abdellrahmanv/PLUTO-2026/feature_memory/STATE-3.33_welcome_talk_v1.md

# Feature Memory: WELCOME_TALK v1 Offline Answer Engine

Status: implemented, local smoke validated

Last updated: 2026-06-09

Last validated: 2026-06-09 local smoke test; Raspberry Pi camera mic/Piper probe recorded in `AUD-001_audio_io_v1.md`

Owner: Pluto systems engineering

## Requirement Trace

Implemented requirements:

```text
TIME-009
AUD-013
AUD-014
AUD-015
AUD-016
AUD-018
AUD-019
AUD-022
STATE-3.33
STATE-3.33.1
STATE-3.33.2
STATE-3.33.3
STATE-3.33.4
STATE-3.33.5
STATE-3.33.6
STATE-3.33.9
STATE-3.33.10
STATE-3.33.11
STATE-3.33.12
STATE-3.33.13
STATE-3.35
STATE-3.37
```

Verification tests:

```text
tools/welcome_talk_smoke.py
tools/web_shell_smoke.py
tools/audio_io_smoke.py
```

## Design Intent

Make WELCOME_TALK fast, offline, and good enough for a welcoming robot. Pluto
answers short visitor questions using a deterministic local response bank
instead of waiting for an LLM.

## Design Decision

v1 uses a local keyword/fuzzy intent engine in:

```text
pluto_runtime/welcome_talk.py
```

This was chosen because Pluto needs small latency more than perfect language
understanding. Ollama/Qwen remains a v1.5 fallback candidate only after a
benchmark gate.

The 2026-06-09 talk expansion keeps the same non-LLM architecture but adds an
alias-assisted word matcher and deterministic script bank. This lets Pluto
answer more naturally around demo, safety, sensors, deployment, and presentation
topics without introducing unbounded generation.

## Interfaces

Inputs:

- Website text fallback through `POST /api/welcome/talk`.
- Camera microphone STT text through `pluto_runtime/audio_io.py`.

Outputs:

- Short response text.
- Response source: `keyword`, `fuzzy`, `fallback`, or `blocked`.
- Intent name, score, input word count, output word count, latency.
- Web status under `status.talk`.

External dependencies:

- None for v1 answer selection.

## Configuration

| Name | Default | Allowed Range | Reason |
| --- | --- | --- | --- |
| `version` | `v1` | `v1` | Locks offline deterministic behavior |
| `primary_engine` | `keyword` | `keyword` | Keeps response path traceable |
| `enable_ollama_fallback` | `false` | bool | v1.5 only after benchmark |
| `max_input_words` | 9 | 1-12 | Keeps questions tiny |
| `max_output_words` | 9 | 1-12 | Keeps answers quick |
| `fuzzy_threshold` | 0.68 | 0.0-1.0 | Allows small STT mistakes |

## Runtime Behavior

The web API only answers while the mode manager is in `WELCOME`. Before
answering, the Pi sends a stop guard to STM32 so wheel motion stays zero during
talk. The persistent STM32 link retries `CMD:STOP` up to three times because a
single `ACK:STOP` can be delayed while telemetry is arriving. If the ACK is
still missing but the STM32 link is recent, wheel speed telemetry is zero, and
manual intent is zero, WELCOME_TALK may proceed in a logged degraded guard mode
because this state is speech-only.

Normal flow:

```text
POST /api/welcome/talk
  -> require current_state == WELCOME
  -> send CMD:STOP
  -> set substate WELCOME_TALK
  -> normalize text
  -> enforce <= 9 input words
  -> keyword/script/fuzzy match
  -> return <= 9 output words
  -> log response source and latency
```

Current bank coverage:

```text
identity: name, project, builders, version
location/demo: MSA University in Egypt, graduation demo, weather
MSA knowledge: official facts, faculties, contacts, partners, campus numbers
system: modes, website, STM32, Raspberry Pi, hoverboard, Uno
safety: stop, obstacle, distance, human safety, camera avoidance
interaction: greeting, goodbye, thanks, welcome wave, approach
personality: feeling, alive, happy, jokes, favorites, dreams
debug: tests, requirements, logs, confidence, noise
audio: microphone, headset/webcam mic, speaker, local/offline speech
deployment: Pi service, Wi-Fi portal, production readiness, branching
script bank: demo open/close, system, safety, sensors, modes, judges
matching method: exact keywords, alias groups, scripted lines, fuzzy fallback
```

Current bank size validated by smoke test:

```text
intent_count >= 180
script_count >= 30
response_bank_size >= 210
alias_group_count >= 20
```

Exact demo facts locked by smoke tests:

```text
"where are you" -> "MSA University in Egypt."
"who made pluto" -> "Abdelrahman and Hamza built me."
"weather" -> "It is slightly hot today."
"what means msa" -> "October University for Modern Sciences and Arts."
```

## How To Run

Local smoke:

```bash
python tools/welcome_talk_smoke.py
python tools/audio_io_smoke.py
```

With an already running Pi web server:

```bash
python tools/welcome_talk_smoke.py --host 192.168.137.2 --port 8080 --external-server --hardware-flow
```

Manual API test:

```bash
curl -X POST http://127.0.0.1:8080/api/welcome/talk \
  -H "Content-Type: application/json" \
  -d '{"text":"what is your name"}'
```

## How To Debug

Checklist:

1. Check `/api/status` and confirm `talk.version` is `v1`.
2. Confirm current state is `WELCOME`; otherwise talk is rejected.
3. Confirm `stop_guard.ok` is true before trusting TALK output.
4. Check `talk.last_result.response_source`.
5. If the response is wrong, add a trigger to `INTENT_RULES` or `SCRIPT_RULES`.
6. If input is blocked, check `input_words`.

Useful commands:

```bash
python tools/welcome_talk_smoke.py
curl http://127.0.0.1:8080/api/status
```

Bank audit:

```bash
python - <<'PY'
from pluto_runtime.welcome_talk import INTENT_RULES, SCRIPT_RULES
for rule in INTENT_RULES:
    print(rule.intent, "=>", rule.response)
for rule in SCRIPT_RULES:
    print(rule.script, rule.step, "=>", rule.response)
PY
```

## Expected Evidence

Known keyword:

```text
response_source=keyword
intent=name
response="I am Pluto."
response_words<=9
```

Long question:

```text
accepted=false
reason=input_too_long
response="Short question please."
```

Scripted prompt:

```text
input="demo script"
response_source=script
intent=script_demo_opening
response="Welcome. I am Pluto, your graduation robot."
```

## Verification Tests

| Test ID | Method | Expected Result | Last Result |
| --- | --- | --- | --- |
| VER-TALK-001 | Known keyword question | `keyword`, answer <= 9 words | local pass |
| VER-TALK-002 | 10-word question | blocked with short-question response | local pass |
| VER-TALK-003 | Response bank audit | all responses <= 9 words | local pass |
| VER-TALK-005 | No internet/API keys | engine imports no cloud dependency | local pass |
| VER-TALK-006 | Demo fact prompts | location/builders/weather exact answers | local pass |
| VER-TALK-007 | MSA knowledge prompts | official MSA facts answer locally | local pass |
| VER-TALK-008 | Script prompt | `script`, answer <= 9 words | 2026-06-09 local pass |
| VER-TALK-009 | Matching-method prompt | local alias/script/fuzzy method explained | 2026-06-09 local pass |

## Failure Modes

| Failure | Likely Cause | Diagnostic | Recovery |
| --- | --- | --- | --- |
| Talk rejected | Not in WELCOME | Check `current_state` | Enter WELCOME first |
| Stop ACK buried | Alert/telemetry flood from STM32 | Check `stop_guard.degraded` and speed telemetry | Speech-only TALK may continue |
| Stop guard fails | STM32 disconnected or nonzero speed | Check `stop_guard.attempts` and STM32 runtime | Fix STM32 link before TALK |
| Wrong answer | Missing trigger or STT error | Check `normalized_text` and `score` | Add trigger or response |
| Over-broad alias | Alias group matches too much | Check `response_source`, `score`, and trigger | Add specific trigger or tighten alias |
| Long input blocked | More than 9 words | Check `input_words` | Ask shorter question |

## Safety Notes

WELCOME_TALK v1 sends no wheel or arm movement. It requires WELCOME state and
uses a `CMD:STOP` guard before answering. Degraded guard mode is allowed only
when STM32 is alive and speed telemetry is zero.

## Open Questions

- Which answers should be promoted into pre-rendered Piper audio?
- Should common TTS lines be cached as audio files in the next phase?

## Change History

| Date | Change | Reason |
| --- | --- | --- |
| 2026-05-27 | Initial implementation memory | WELCOME_TALK v1 answer engine added |
| 2026-05-27 | Expanded demo bank | Add MSA University, builders, weather, safety, and interaction facts |
| 2026-05-27 | Added MSA knowledge bank | Add short official-source facts about MSA University |
| 2026-06-09 | Added scripted matching bank | Make talk feel richer without enabling an LLM |
