abdellrahmanv/PLUTO-2026/docs/figures/pluto_runtime_flowchart_book_ready.pdf

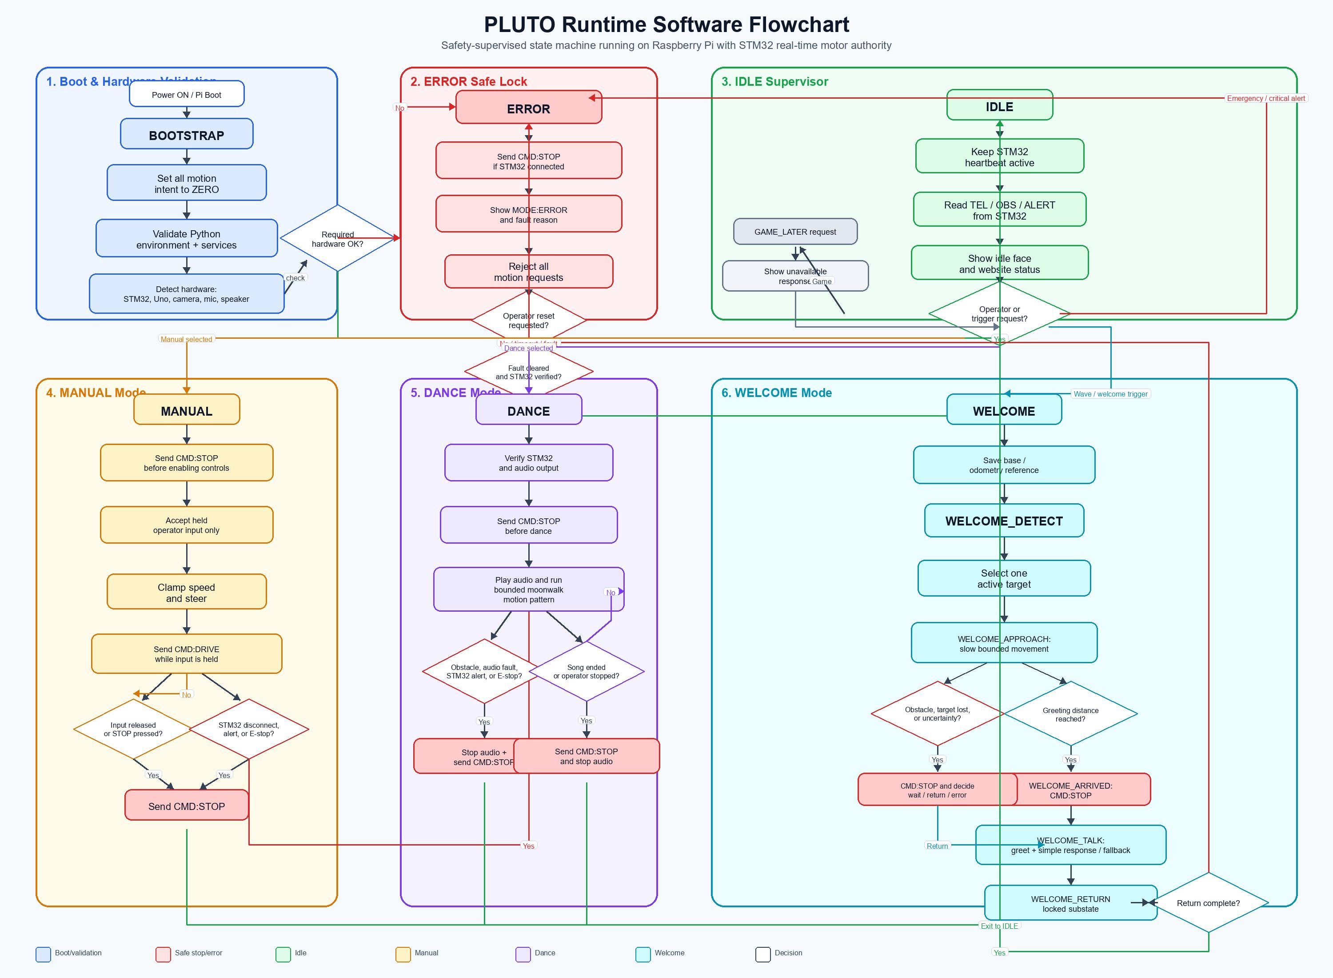
[picture p1: page 1]
