abdellrahmanv/PLUTO-2026/docs/figures/pluto_runtime_flowchart_professional.pdf

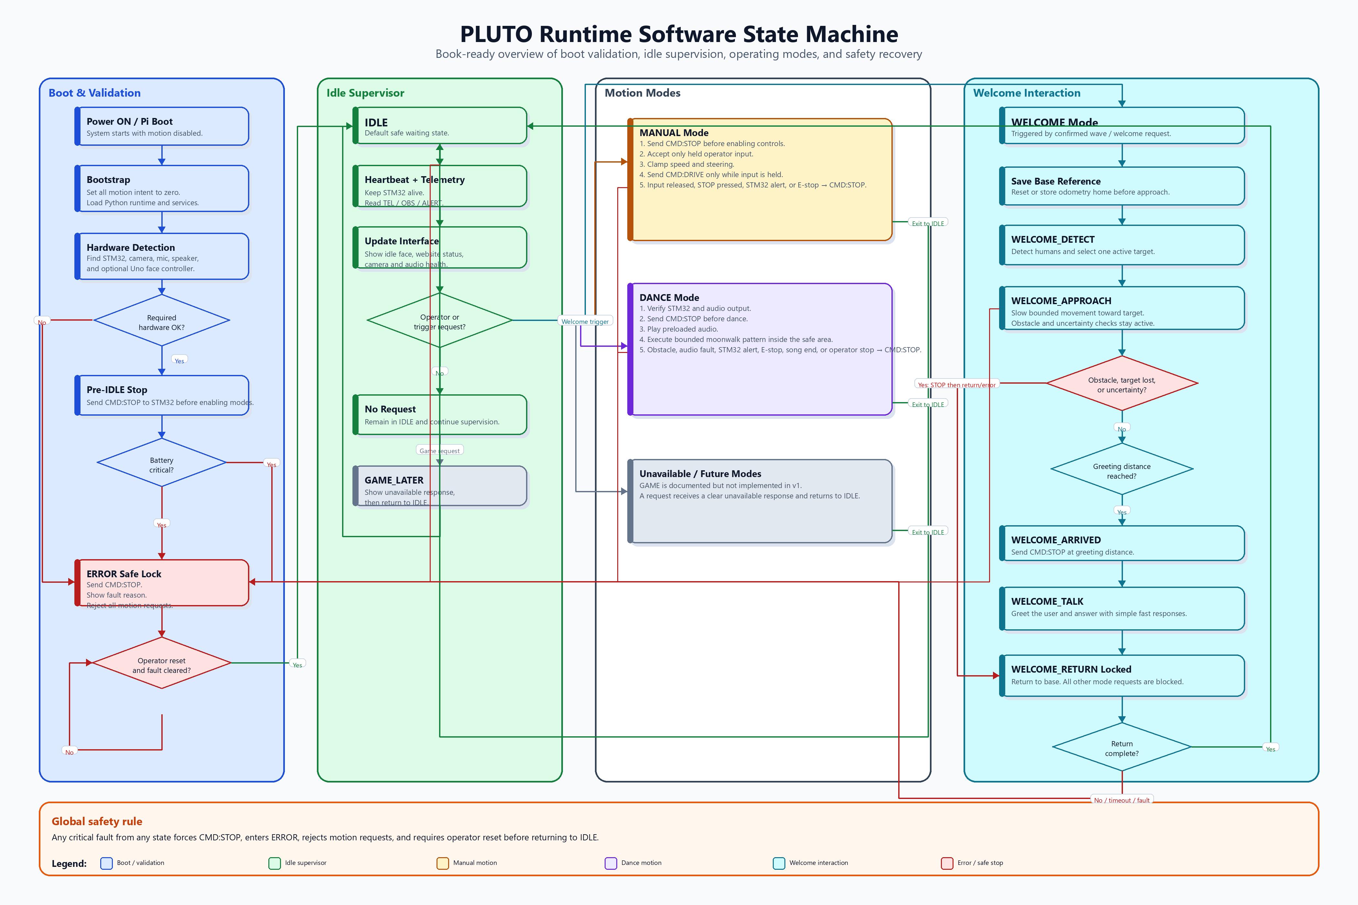
[picture p2: page 1]
