abdellrahmanv/PLUTO-2026/docs/figures/pluto_runtime_flowchart_professional_v3.pdf

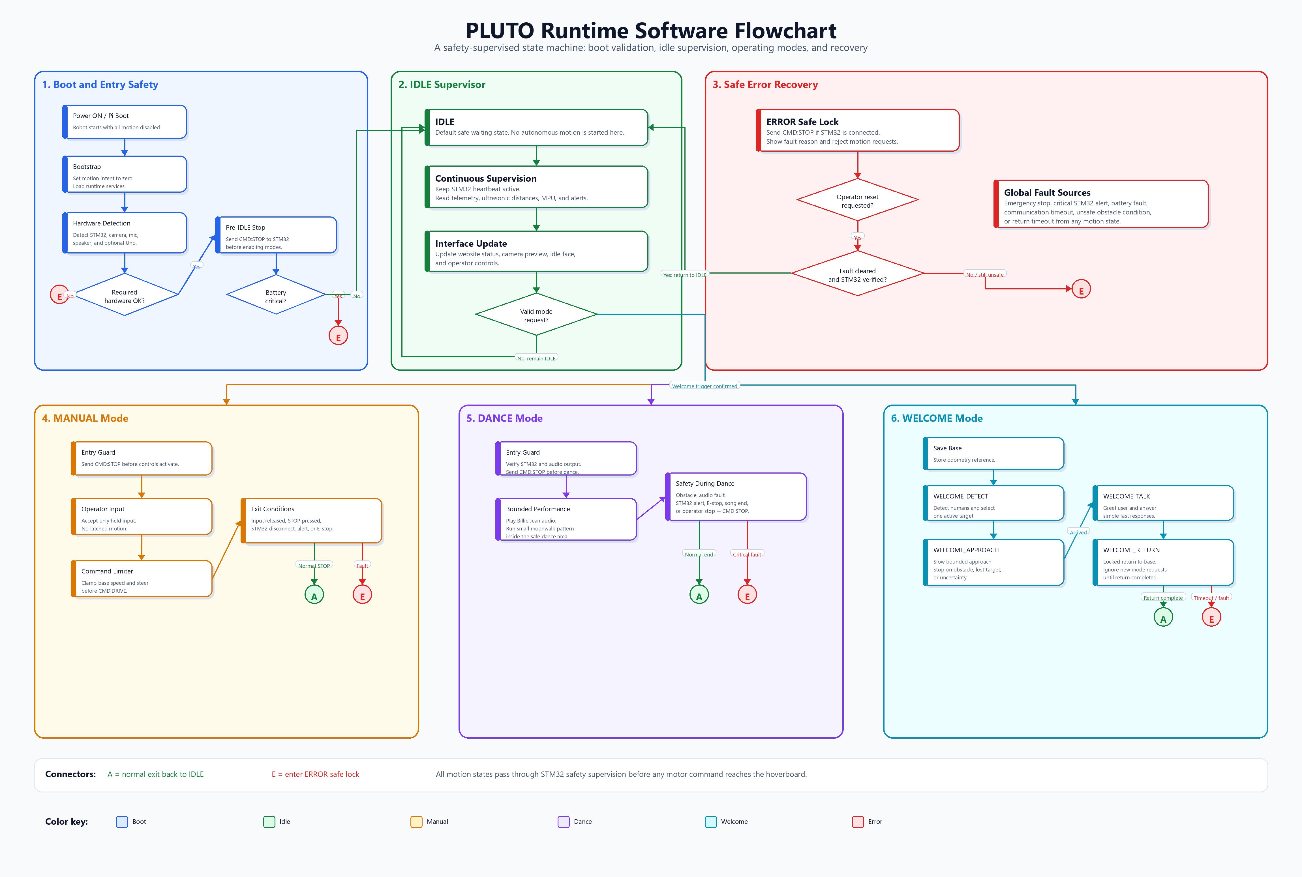
[picture p3: page 1]
