abdellrahmanv/PLUTO-2026/docs/figures/pluto_runtime_flowchart_professional_v3.png

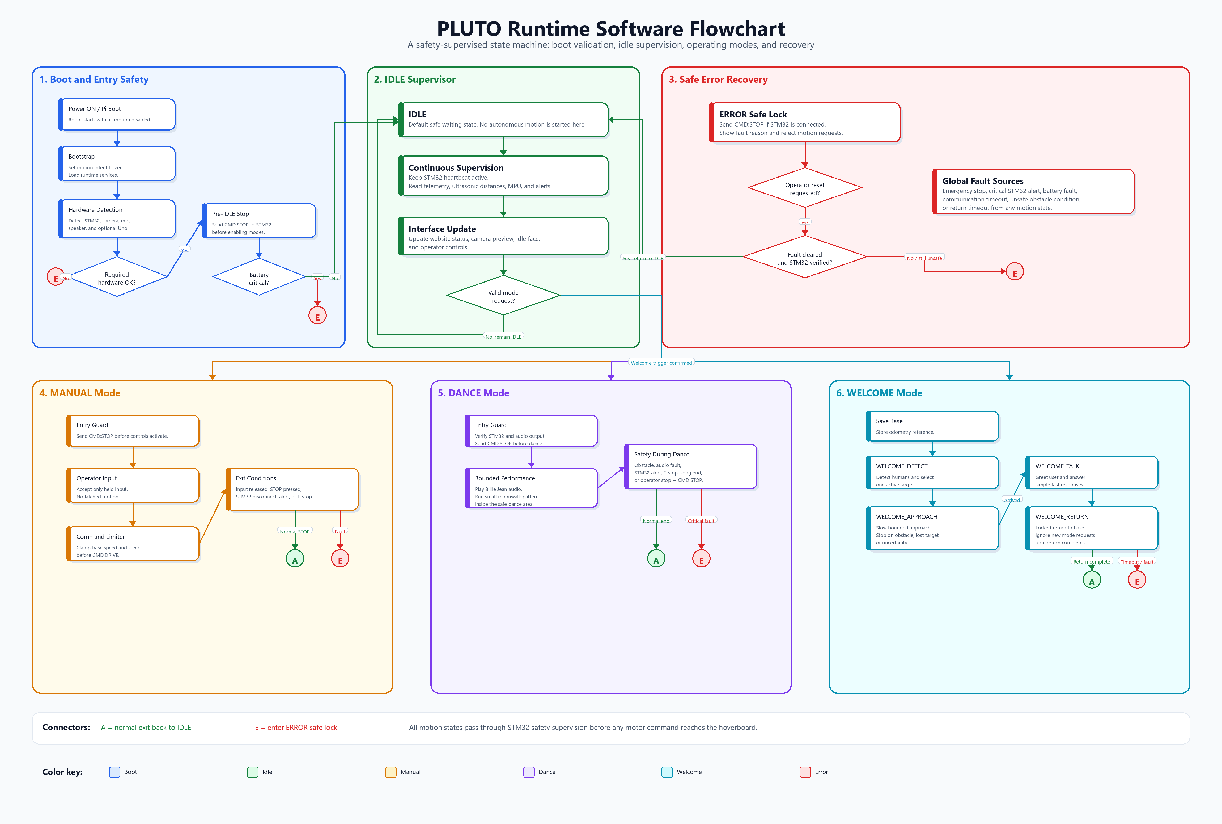
docs/figures/pluto_runtime_flowchart_professional_v3.png
