abdellrahmanv/PLUTO-2026/pluto_runtime/static/robot_meshes/back_leftwheel.STL

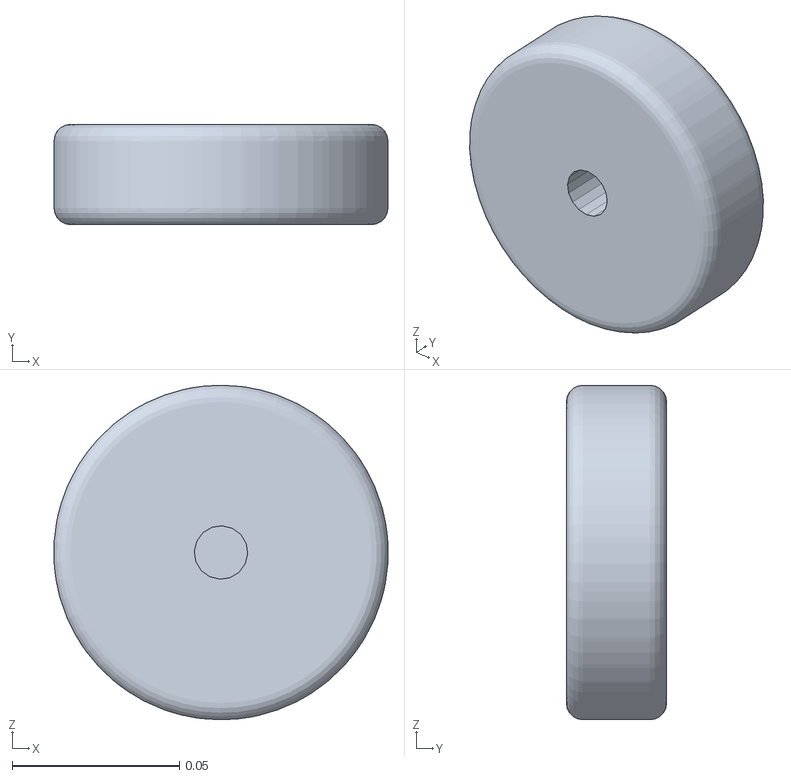
[picture p5: CAD file, 2026-06-17]
pluto_runtime/static/robot_meshes/back_leftwheel.STL
0.0999 x 0.03 x 0.1
