abdellrahmanv/PLUTO-2026/pluto_runtime/static/robot_meshes/leftarm.STL

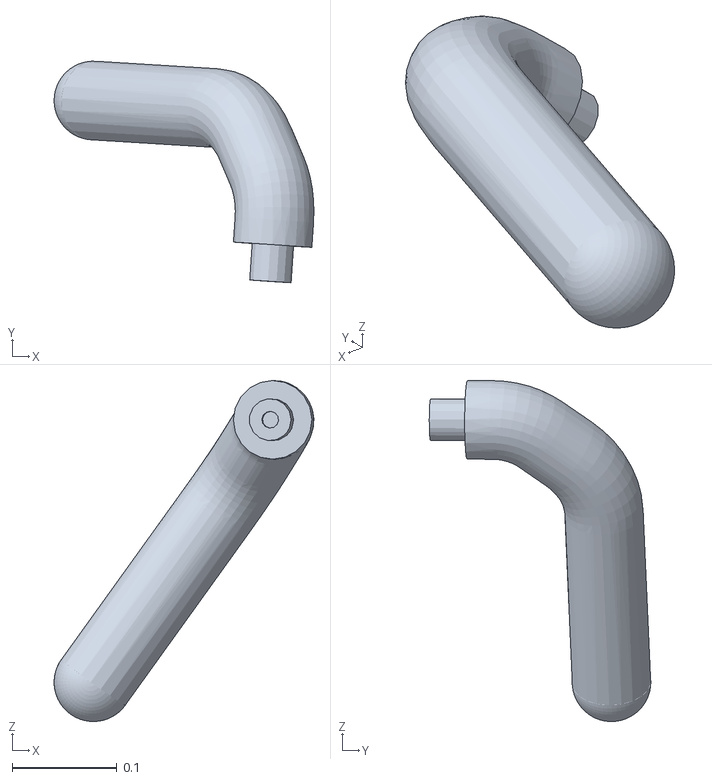
[picture p6: CAD file, 2026-06-17]
pluto_runtime/static/robot_meshes/leftarm.STL
0.248 x 0.211 x 0.325
