abdellrahmanv/PLUTO-2026/pluto_runtime/static/robot_meshes/base_link.STL

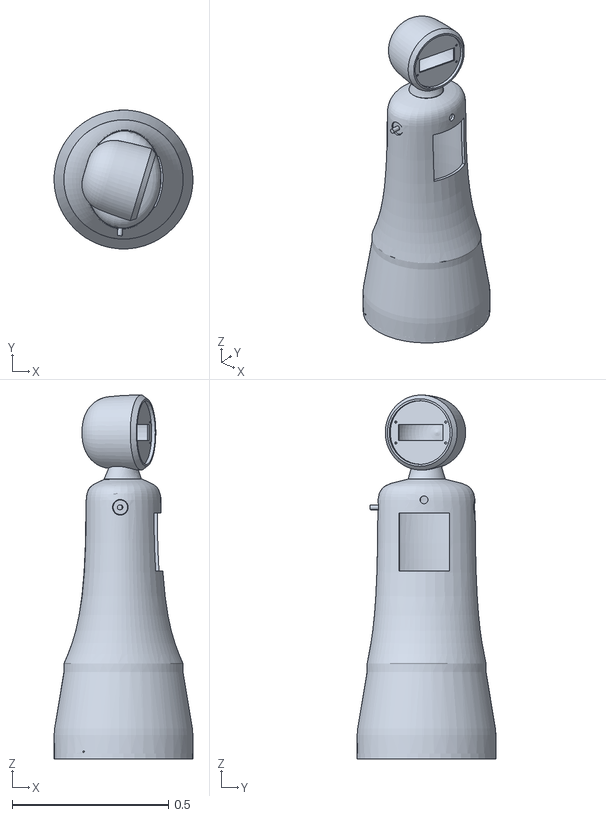
[picture p7: CAD file, 2026-06-17]
pluto_runtime/static/robot_meshes/base_link.STL
0.444 x 0.444 x 1.16
