abdellrahmanv/PLUTO-2026/pluto_runtime/static/robot_meshes/rightarm.STL

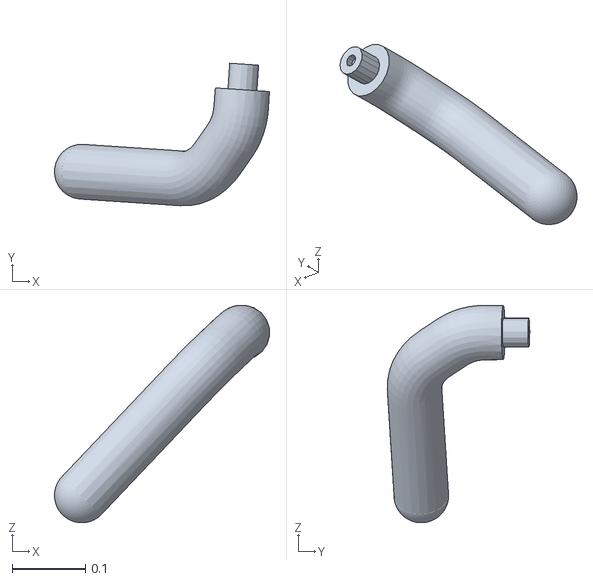
[picture p8: CAD file, 2026-06-17]
pluto_runtime/static/robot_meshes/rightarm.STL
0.294 x 0.195 x 0.298
