abdellrahmanv/PLUTO-2026/(list of files, cad)

Other CAD files:
pluto_runtime/static/robot_meshes/back_rigtwheel.STL
pluto_runtime/static/robot_meshes/front_rightwheel.STL
pluto_runtime/static/robot_meshes/front_leftwheel.STL
