abdellrahmanv/PLUTO-2026/pluto_runtime/web_shell.py

#!/usr/bin/env python3
"""
Phase 6 PLUTO operator website shell.

This is intentionally not the final app. It provides the first safe operator
console surface: project identity, state/status display, hardware status,
events, blocked state requests, and emergency stop wiring.
"""

from __future__ import annotations

import argparse
import glob
import json
import math
import platform
import socket
import subprocess
import sys
import threading
import time
import wave
from collections import deque
from dataclasses import asdict, dataclass, field
from datetime import datetime
from http import HTTPStatus
from http.server import BaseHTTPRequestHandler, ThreadingHTTPServer
from pathlib import Path
from typing import Any, Iterable
from urllib.parse import urlparse

from .audio_io import AudioRuntime
from .camera import CameraService, CameraStatus, status_to_dict
from .dance import DanceDryRunPlanner, DanceStatus
from .dance_live import (
    DISTANCE_TOLERANCE_M,
    MAX_SPEED as DANCE_MAX_SPEED,
    MIN_SPEED as DANCE_MIN_SPEED,
    MIN_STEER as DANCE_MIN_STEER,
    SAFE_OBSTACLE_DISTANCE_CM as DANCE_SAFE_OBSTACLE_DISTANCE_CM,
    TARGET_DISTANCE_M as DANCE_TARGET_DISTANCE_M,
    TARGET_TURN_DEG as DANCE_TARGET_TURN_DEG,
    TURN_TOLERANCE_DEG,
    angle_delta_deg,
)
from .mode_manager import SafetyContext, ModeManager, VALID_STATES
from .stm32_link import Stm32SerialLink, status_to_dict as stm32_status_to_dict
from .validation_center import ValidationCenter
from .wave_detection import SimpleWaveDetector
from .welcome_approach import ApproachStatus, WelcomeApproachPlanner
from .welcome_interaction import WelcomeInteractionFSM
from .welcome_talk import TalkResult, WelcomeTalkEngine


PROJECT_NAME = "PLUTO"
STM32_ID = "ID:STM32_MOTOR"
UNO_ID = "ID:UNO_LCD"
STATIC_DIR = Path(__file__).resolve().with_name("static")
DANCE_FALLBACK_AUDIO = Path("/tmp/pluto_dance_beat.wav")
DANCE_OPEN_LOOP_MOVE_S = 2.0
DANCE_OPEN_LOOP_TURN_S = 1.6
STATIC_TYPES = {
    ".js": "text/javascript; charset=utf-8",
    ".mjs": "text/javascript; charset=utf-8",
    ".css": "text/css; charset=utf-8",
    ".png": "image/png",
    ".jpg": "image/jpeg",
    ".jpeg": "image/jpeg",
    ".svg": "image/svg+xml",
    ".stl": "model/stl",
}


@dataclass
class HardwareDevice:
    name: str
    required: bool
    connected: bool = False
    port: str | None = None
    status: str = "unknown"
    detail: str = "not checked"
    latency_ms: float | None = None
    last_seen: float | None = None


@dataclass
class Event:
    timestamp: float
    level: str
    message: str


@dataclass
class PlutoStatus:
    project: str = PROJECT_NAME
    current_state: str = "BOOTSTRAP"
    current_substate: str = "WEB_SHELL"
    fault_reason: str | None = None
    git_commit: str = "unknown"
    started_at: float = field(default_factory=time.time)
    hardware: dict[str, HardwareDevice] = field(default_factory=dict)
    allowed_next_states: list[dict[str, Any]] = field(default_factory=list)
    bootstrap_report: dict[str, Any] = field(default_factory=dict)
    camera: dict[str, Any] = field(default_factory=dict)
    mode_manager: dict[str, Any] = field(default_factory=dict)
    stm32_runtime: dict[str, Any] = field(default_factory=dict)
    error: dict[str, Any] = field(default_factory=dict)
    manual: dict[str, Any] = field(default_factory=dict)
    wave: dict[str, Any] = field(default_factory=dict)
    welcome_interaction: dict[str, Any] = field(default_factory=dict)
    welcome_approach: dict[str, Any] = field(default_factory=dict)
    dance: dict[str, Any] = field(default_factory=dict)
    talk: dict[str, Any] = field(default_factory=dict)
    audio: dict[str, Any] = field(default_factory=dict)
    events: list[Event] = field(default_factory=list)


@dataclass
class ManualRuntime:
    enabled: bool = False
    speed_intent: int = 0
    steer_intent: int = 0
    max_speed: int = 400
    max_steer: int = 400
    base_speed_setting: int = 100
    base_steer_setting: int = 100
    arm_step_setting: int = 5000
    arm_speed_setting: int = 2000
    max_arm_steps: int = 10000
    max_arm_speed: int = 3000
    command_period_ms: int = 40
    last_command_at: float | None = None
    last_intent_at: float | None = None
    last_repeat_at: float | None = None
    last_release_at: float | None = None
    last_neutral_at: float | None = None
    last_neutral_result: dict[str, Any] = field(default_factory=dict)
    last_repeat_result: dict[str, Any] = field(default_factory=dict)
    last_arm_command: dict[str, Any] = field(default_factory=dict)
    last_result: dict[str, Any] = field(default_factory=dict)
    command_count: int = 0
    repeat_count: int = 0
    blocked_reason: str | None = None


@dataclass
class DanceLiveRuntime:
    enabled: bool = False
    active: bool = False
    use_ultrasonic: bool = True
    current_step: str = "idle"
    step_index: int = 0
    total_steps: int = 6
    started_at: float | None = None
    completed_at: float | None = None
    last_update_at: float | None = None
    last_result: dict[str, Any] = field(default_factory=dict)
    last_error: str | None = None
    last_command: dict[str, Any] = field(default_factory=dict)
    measured_distance_m: float = 0.0
    measured_turn_deg: float = 0.0
    target_distance_m: float = DANCE_TARGET_DISTANCE_M
    target_turn_deg: float = DANCE_TARGET_TURN_DEG
    forward_speed: int = DANCE_MAX_SPEED
    backward_speed: int = DANCE_MIN_SPEED
    rotation_steer: int = DANCE_MIN_STEER
    obstacle_stop_cm: float = DANCE_SAFE_OBSTACLE_DISTANCE_CM
    audio_file: str | None = None


@dataclass
class WaveTriggerRuntime:
    enabled: bool = True
    detector_status: str = "tracked_pose_wave"
    sample_hz: float = 8.0
    last_sample_at: float | None = None
    thresholds: dict[str, Any] = field(default_factory=dict)
    armed_until: float = 0.0
    armed_source: str | None = None
    trigger_count: int = 0
    rejected_count: int = 0
    last_event: dict[str, Any] | None = None
    last_result: dict[str, Any] | None = None
    last_reason: str = "no wave trigger yet"
    detector: dict[str, Any] = field(default_factory=dict)
    pending_confirmed_until: float = 0.0
    last_confirmed_detector: dict[str, Any] = field(default_factory=dict)


class PlutoWebContext:
    def __init__(
        self,
        serial_baud: int = 115200,
        camera_device: str | None = None,
        camera_resolution: tuple[int, int] = (320, 320),
        camera_fps: int = 30,
        camera_stream_fps: int = 8,
        camera_frame_skip: int = 1,
        camera_detection_hold: float = 2.0,
        camera_confidence: float = 0.30,
        camera_disabled: bool = False,
        yolo_model: str | None = None,
        wave_pose_model: str | None = None,
        wave_pose_disabled: bool = False,
        wave_pose_frame_skip: int = 1,
        wave_pose_max_tracks: int = 2,
        microphone_device: str | None = None,
        speaker_device: str | None = None,
        fast_start: bool = False,
    ) -> None:
        self.serial_baud = serial_baud
        self.lock = threading.RLock()
        self.events: deque[Event] = deque(maxlen=80)
        self.started_at = time.time()
        self.mode_manager = ModeManager()
        self.stm32_link: Stm32SerialLink | None = None
        self.manual = ManualRuntime()
        self.wave = WaveTriggerRuntime()
        self.wave_detector = SimpleWaveDetector()
        self.wave.thresholds = self.wave_detector.thresholds()
        self.wave_thread_running = True
        self.wave_thread: threading.Thread | None = None
        self.manual_thread_running = True
        self.manual_thread: threading.Thread | None = None
        self.startup_thread: threading.Thread | None = None
        self.uno_thread_running = False
        self.uno_thread: threading.Thread | None = None
        self.uno_port: str | None = None
        self.approach_planner = WelcomeApproachPlanner()
        self.approach_status = ApproachStatus()
        self.approach_last_stop_at = 0.0
        self.dance_planner = DanceDryRunPlanner()
        self.dance_status = DanceStatus()
        self.dance_started_at: float | None = None
        self.dance_last_stop_at = 0.0
        self.dance_audio_started = False
        self.dance_live = DanceLiveRuntime()
        self.dance_live_thread: threading.Thread | None = None
        self.dance_live_stop = threading.Event()
        self.talk_engine = WelcomeTalkEngine()
        self.talk_last_result: TalkResult | None = None
        self.talk_history: deque[TalkResult] = deque(maxlen=20)
        self.talk_last_notice = "Enter WELCOME, then ask a short question."
        self.audio_runtime = AudioRuntime(preferred_microphone=microphone_device, preferred_speaker=speaker_device)
        self.auto_welcome_no_human_since: float | None = None
        self.validation_center = ValidationCenter()
        self.last_alert_escalated: str | None = None
        self.git_commit = read_git_commit()
        self.camera_disabled = camera_disabled
        self.camera_resolution = camera_resolution
        self.camera_frame_skip = camera_frame_skip
        self.hardware = {
            "stm32": HardwareDevice("STM32 motor safety controller", True),
            "uno": HardwareDevice("Uno LCD face controller", False),
            "camera": HardwareDevice("Camera", False, status="starting", detail="Phase 4"),
            "speaker": HardwareDevice("Speaker", False, status="starting", detail="Phase 9 audio"),
            "microphone": HardwareDevice("Microphone", False, status="starting", detail="Phase 9 audio"),
        }
        self.log("info", "PLUTO web shell starting")
        self.camera_service = CameraService(
            device=camera_device,
            resolution=camera_resolution,
            framerate=camera_fps,
            stream_fps=camera_stream_fps,
            frame_skip=camera_frame_skip,
            detection_hold_s=camera_detection_hold,
            confidence_threshold=camera_confidence,
            model_path=yolo_model,
            pose_model_path=wave_pose_model,
            pose_enabled=not wave_pose_disabled,
            pose_frame_skip=wave_pose_frame_skip,
            pose_max_tracks=wave_pose_max_tracks,
        )
        self.camera_perception_mode = "NORMAL"
        self.welcome_interaction = WelcomeInteractionFSM(
            camera_status=lambda: status_to_dict(self.camera_service.get_status()),
            audio_runtime=self.audio_runtime,
            talk_engine=self.talk_engine,
            mode_state=lambda: self.mode_manager.current_state,
            stop_guard=lambda: self.degraded_stop_guard_if_safe(self.send_stm32_stop_safe(self.hardware["stm32"].port)),
            log=self.log,
            on_talk_result=self.record_welcome_talk_result,
        )
        self.start_wave_monitor()
        self.start_manual_drive_repeater()
        if fast_start:
            self.bootstrap_report = {
                "phase": "fast startup",
                "status": "serving website while camera, audio, and serial hardware initialize in background",
            }
            self.log("info", "Fast start enabled: website binds before camera/audio/serial probes finish")
            self.start_deferred_startup()
        else:
            self.start_camera_service()
            self.refresh_hardware()

    def log(self, level: str, message: str) -> None:
        with self.lock:
            self.events.appendleft(Event(time.time(), level, message))

    def start_deferred_startup(self) -> None:
        if self.startup_thread and self.startup_thread.is_alive():
            return
        self.startup_thread = threading.Thread(target=self._deferred_startup_loop, name="pluto-fast-start", daemon=True)
        self.startup_thread.start()

    def _deferred_startup_loop(self) -> None:
        try:
            self.start_camera_service()
        except Exception as exc:
            self.log("warn", f"Deferred camera startup failed: {exc}")
        try:
            self.refresh_hardware()
        except Exception as exc:
            self.log("error", f"Deferred hardware refresh failed: {exc}")

    def start_camera_service(self) -> None:
        if self.camera_disabled:
            self.camera_service.status = CameraStatus(
                available=False,
                running=False,
                configured_resolution=[self.camera_resolution[0], self.camera_resolution[1]],
                frame_skip=max(1, self.camera_frame_skip),
                detector_status="disabled",
                pose_status="disabled",
                error="camera disabled by operator",
                details={"reason": "camera disabled by --camera-disabled"},
            )
            self.log("warn", "Camera service disabled by operator")
        elif self.camera_service.start():
            self.log("pass", "Camera service started")
        else:
            self.log("warn", f"Camera unavailable: {self.camera_service.get_status().error}")

    def start_wave_monitor(self) -> None:
        if self.wave_thread and self.wave_thread.is_alive():
            return
        self.wave_thread_running = True
        self.wave_thread = threading.Thread(target=self._wave_monitor_loop, name="pluto-wave-monitor", daemon=True)
        self.wave_thread.start()

    def start_manual_drive_repeater(self) -> None:
        if self.manual_thread and self.manual_thread.is_alive():
            return
        self.manual_thread_running = True
        self.manual_thread = threading.Thread(target=self._manual_drive_repeat_loop, name="pluto-manual-drive", daemon=True)
        self.manual_thread.start()

    def stop(self) -> None:
        self.wave_thread_running = False
        if self.wave_thread and self.wave_thread.is_alive():
            self.wave_thread.join(timeout=1.0)
        self.manual_thread_running = False
        if self.manual_thread and self.manual_thread.is_alive():
            self.manual_thread.join(timeout=1.0)
        self.stop_live_dance("web shell stopping")
        self.stop_uno_button_monitor()
        self.welcome_interaction.stop("web shell stopping")
        self.stop_stm32_link()
        self.audio_runtime.stop_playback(reason="web shell stopping")
        self.camera_service.stop()
        if self.startup_thread and self.startup_thread.is_alive():
            self.startup_thread.join(timeout=1.0)

    def _wave_monitor_loop(self) -> None:
        period_s = 1.0 / max(1.0, self.wave.sample_hz)
        while self.wave_thread_running:
            started = time.monotonic()
            try:
                with self.lock:
                    self.update_wave_detector()
                    self.process_idle_wave_trigger()
                    self.process_idle_human_trigger()
                    self.process_welcome_auto_return()
                    self.wave.last_sample_at = time.time()
            except Exception as exc:
                self.log("warn", f"Wave monitor error: {exc}")
                time.sleep(0.5)
            elapsed = time.monotonic() - started
            time.sleep(max(0.01, period_s - elapsed))

    def _manual_drive_repeat_loop(self) -> None:
        next_send = time.monotonic()
        while self.manual_thread_running:
            period_s = max(0.02, float(self.manual.command_period_ms) / 1000.0)
            speed = 0
            steer = 0
            active = False
            with self.lock:
                active = (
                    self.mode_manager.current_state == "MANUAL"
                    and self.manual.enabled
                    and self.stm32_link is not None
                    and self.hardware["stm32"].connected
                    and (self.manual.speed_intent != 0 or self.manual.steer_intent != 0)
                )
                if active:
                    speed = self.manual.speed_intent
                    steer = self.manual.steer_intent

            now = time.monotonic()
            if not active:
                next_send = now + period_s
                time.sleep(0.01)
                continue

            if now < next_send:
                time.sleep(min(0.01, next_send - now))
                continue

            result = self._send_manual_drive_command(speed, steer, wait_ack=False, log_motion=False)
            with self.lock:
                self.manual.last_repeat_at = time.time()
                self.manual.last_repeat_result = result
                self.manual.repeat_count += 1
                if not result.get("ok"):
                    self.manual.blocked_reason = str(result.get("detail") or "manual repeat failed")
            next_send += period_s
            if next_send < now - period_s:
                next_send = now + period_s

    def refresh_hardware(self) -> None:
        self.stop_uno_button_monitor()
        self.stop_stm32_link()
        ports = candidate_ports()
        self.log("info", f"Scanning serial ports: {', '.join(ports) if ports else 'none'}")

        stm32 = probe_stm32(ports, self.serial_baud)
        uno = probe_uno(ports, self.serial_baud, skip_port=stm32.port if stm32.connected else None)
        audio_status = self.audio_runtime.probe()

        with self.lock:
            self.hardware["stm32"] = stm32
            self.hardware["uno"] = uno
            camera_status = self.camera_service.get_status()
            self.hardware["camera"] = HardwareDevice(
                "Camera",
                False,
                connected=camera_status.available,
                port=str(camera_status.device) if camera_status.device is not None else None,
                status="connected" if camera_status.available else "unavailable",
                detail=camera_status.error or f"{camera_status.backend} {camera_status.resolution}",
                last_seen=time.time() if camera_status.available else None,
            )
            self.hardware["microphone"] = HardwareDevice(
                "Microphone",
                False,
                connected=audio_status.microphone_available,
                port=audio_status.selected_microphone,
                status="connected" if audio_status.microphone_available else "unavailable",
                detail=audio_status.stt_detail if audio_status.microphone_available else "no capture device selected",
                last_seen=time.time() if audio_status.microphone_available else None,
            )
            self.hardware["speaker"] = HardwareDevice(
                "Speaker",
                False,
                connected=audio_status.speaker_available,
                port=audio_status.selected_speaker,
                status="connected" if audio_status.speaker_available else "unavailable",
                detail=audio_status.tts_detail
                if audio_status.speaker_available
                else (
                    "playback device detected but no confirmed speaker selected"
                    if audio_status.playback_devices
                    else "no playback device selected"
                ),
                last_seen=time.time() if audio_status.speaker_available else None,
            )
            self.bootstrap_report = {
                "phase": "Phase 9 WELCOME talk/audio baseline",
                "serial_ports": ports,
                "required_hardware": {"stm32": asdict(stm32)},
                "optional_hardware": {
                    "uno": asdict(uno),
                    "camera": status_to_dict(camera_status),
                    "audio": audio_status.to_dict(),
                },
                "notes": [
                    "Website shell does not enable motion states.",
                    "Emergency stop sends CMD:STOP when STM32 is available.",
                    "IDLE runtime keeps STM32 heartbeat alive when connected.",
                    "Camera feed uses threaded capture, frame skipping, MJPG, low resolution, and warmup suppression.",
                    "WELCOME wave uses quantized MoveNet pose when available; pixel motion is debug-only.",
                    "WELCOME_TALK v1 can use website text, camera microphone STT, and local Piper TTS when available.",
                    "WELCOME_APPROACH Phase 10 is dry-run only: it computes target, safety, and proposed motion while holding STOP.",
                    "DANCE is dry-run only until bounded audio, obstacle, and proposed-motion evidence are reviewed.",
                ],
            }
            if stm32.connected:
                self.log("pass", f"STM32 detected on {stm32.port}")
                self.start_stm32_link(stm32.port)
                if self.mode_manager.current_state == "BOOTSTRAP":
                    self.mode_manager.bootstrap_complete(True, "required hardware available")
            else:
                self.log("error", "STM32 motor safety controller missing")
                if self.mode_manager.current_state == "BOOTSTRAP":
                    self.mode_manager.bootstrap_complete(False, "STM32 motor safety controller missing")
                elif self.mode_manager.current_state != "ERROR":
                    self.mode_manager.enter_error("STM32 motor safety controller missing", source="hardware_refresh")

        if uno.connected:
            self.start_uno_button_monitor(uno.port)

    def start_stm32_link(self, port: str | None) -> None:
        if not port:
            return
        self.stop_stm32_link()
        link = Stm32SerialLink(port=port, baud=self.serial_baud, heartbeat_interval_s=0.4)
        link.start()
        self.stm32_link = link
        self.log("pass", f"IDLE STM32 heartbeat link started on {port}")

    def stop_stm32_link(self) -> None:
        link = self.stm32_link
        self.stm32_link = None
        if link is not None:
            link.stop()

    def start_uno_button_monitor(self, port: str | None) -> None:
        if not port:
            return
        if self.uno_thread and self.uno_thread.is_alive() and self.uno_port == port:
            return
        self.stop_uno_button_monitor()
        self.uno_port = port
        self.uno_thread_running = True
        self.uno_thread = threading.Thread(
            target=self._uno_button_monitor_loop,
            args=(port,),
            name="pluto-uno-buttons",
            daemon=True,
        )
        self.uno_thread.start()
        self.log("pass", f"Uno button listener started on {port}")

    def stop_uno_button_monitor(self) -> None:
        self.uno_thread_running = False
        thread = self.uno_thread
        self.uno_thread = None
        self.uno_port = None
        if thread and thread.is_alive():
            thread.join(timeout=1.0)

    def _uno_button_monitor_loop(self, port: str) -> None:
        while self.uno_thread_running and self.uno_port == port:
            try:
                with serial_open(port, self.serial_baud) as ser:
                    time.sleep(1.8)
                    serial_write(ser, "ID?")
                    while self.uno_thread_running and self.uno_port == port:
                        line = serial_read_line(ser)
                        if not line:
                            time.sleep(0.02)
                            continue
                        if line == UNO_ID or line.startswith(("ACK:", "TOUCH:")):
                            continue
                        if not line.startswith("BTN:"):
                            continue

                        command = line.split(":", 1)[1].strip()
                        result = self.handle_uno_button(command)
                        current_state = str(result.get("state") or result.get("current_state") or self.mode_manager.current_state)
                        try:
                            serial_write(ser, f"ACK:BTN:{command}")
                            serial_write(ser, f"MODE:{current_state}")
                            if result.get("accepted") is False:
                                reason = str(result.get("reason") or "command rejected")[:36]
                                serial_write(ser, f"WARN:{reason}")
                        except Exception as exc:
                            self.log("warn", f"Uno button ACK failed: {exc}")
            except Exception as exc:
                if self.uno_thread_running and self.uno_port == port:
                    self.log("warn", f"Uno button listener error on {port}: {exc}")
                    time.sleep(1.0)

    def handle_uno_button(self, command: str) -> dict[str, Any]:
        normalized = command.strip().upper().replace("-", "_").replace(" ", "_")
        if normalized in {"EMERGENCY_STOP", "ESTOP", "E_STOP", "STOP"}:
            stop = self.emergency_stop(source="uno_button")
            return {"accepted": True, "state": stop["state"], "emergency_stop": stop}
        if normalized in {"IDLE", "WELCOME", "DANCE"}:
            return self.request_state(normalized, reset_fault=normalized == "IDLE", source="uno_button")

        self.log("warn", f"Uno button ignored unknown command: {command}")
        return {"accepted": False, "state": self.mode_manager.current_state, "reason": "unknown Uno button command"}

    def emergency_stop(self, source: str = "website") -> dict[str, Any]:
        started = time.monotonic()
        stm32 = self.hardware["stm32"]
        self.dance_live_stop.set()
        stop = self.send_stm32_stop_safe(stm32.port)
        self.audio_runtime.stop_playback(reason="emergency stop")
        elapsed_ms = (time.monotonic() - started) * 1000.0

        with self.lock:
            result = self.mode_manager.enter_error(f"Emergency stop requested from {source}", source=source)
            self.manual.enabled = False
            self.manual.speed_intent = 0
            self.manual.steer_intent = 0
            self.dance_live.active = False
            self.dance_live.enabled = False
            self.dance_live.current_step = "emergency_stop"
            self.log("stop", f"Emergency stop requested from {source}, serial result: {stop['detail']}")

        return {
            "ok": bool(stop["ok"]),
            "elapsed_ms": elapsed_ms,
            "serial": stop,
            "state": result.current_state,
            "transition": result.to_dict(),
        }

    def inject_fault(self, reason: str, source: str = "diagnostic") -> dict[str, Any]:
        clean_reason = reason.strip() or "diagnostic fault injection"
        stop = self.send_stm32_stop_safe(self.hardware["stm32"].port)
        with self.lock:
            result = self.mode_manager.enter_error(clean_reason, source=source)
            self.manual.enabled = False
            self.manual.speed_intent = 0
            self.manual.steer_intent = 0
            self.log("error", f"Fault injected: {clean_reason}; stop result: {stop['detail']}")
        return {"accepted": True, "stop": stop, "transition": result.to_dict(), "state": result.current_state}

    def reset_error(self) -> dict[str, Any]:
        if not self.hardware["stm32"].connected:
            self.refresh_hardware()
        result = self.mode_manager.request_transition(
            "IDLE",
            self.safety_context(),
            source="website",
            reason="operator requested ERROR reset",
            reset_fault=True,
        )
        stop_result: dict[str, Any] | None = None
        if result.accepted and result.requires_stop:
            stop_result = self.send_stm32_stop_safe(self.hardware["stm32"].port)
            self.log("stop", f"ERROR reset stop guard: {stop_result['detail']}")
        self.log("pass" if result.accepted else "warn", f"ERROR reset: {result.reason}")
        payload = result.to_dict()
        payload["stop_guard"] = stop_result
        return payload

    def send_stm32_stop_safe(self, port: str | None) -> dict[str, Any]:
        if self.stm32_link is not None:
            return self.stm32_link.send_stop()
        return send_stm32_stop(port, self.serial_baud) if port else {"ok": False, "detail": "STM32 port unknown"}

    def safety_context(self, operator_request: bool = False, welcome_trigger_confirmed: bool = False) -> SafetyContext:
        stm32 = self.hardware["stm32"]
        return SafetyContext(
            stm32_available=stm32.connected,
            battery_critical=False,
            motion_intent_zero=True,
            welcome_trigger_confirmed=welcome_trigger_confirmed,
            operator_request=operator_request,
            return_lock=self.mode_manager.return_lock,
            fault_active=False,
            fault_reason=self.mode_manager.fault_reason,
        )

    def request_state(self, requested_state: str, reset_fault: bool = False, source: str = "website") -> dict[str, Any]:
        requested_state = requested_state.strip().upper()
        if requested_state not in VALID_STATES:
            self.log("warn", f"Rejected unknown state request: {requested_state}")
            return {"accepted": False, "reason": "unknown state"}

        context = self.safety_context(
            operator_request=True,
            welcome_trigger_confirmed=requested_state == "WELCOME",
        )
        result = self.mode_manager.request_transition(
            requested_state,
            context,
            source=source,
            reason=f"{source} requested {requested_state}",
            reset_fault=reset_fault,
        )

        stop_result: dict[str, Any] | None = None
        if result.accepted and result.requires_stop:
            stm32 = self.hardware["stm32"]
            stop_result = self.send_stm32_stop_safe(stm32.port)
            self.log("stop", f"Transition stop guard for {requested_state}: {stop_result['detail']}")

        manual_neutral: dict[str, Any] | None = None
        if result.accepted:
            if result.previous_state == "DANCE" and result.current_state != "DANCE" and self.dance_live.active:
                self.stop_live_dance(f"transitioned to {result.current_state}")
            if result.current_state == "MANUAL" or self.manual.enabled:
                manual_neutral = self.update_manual_enabled(result.current_state == "MANUAL")
            self.update_perception_workload(result.current_state)
            if result.current_state == "WELCOME":
                self.auto_welcome_no_human_since = None
                self.welcome_interaction.start(
                    trigger_source="website",
                    operator_triggered=True,
                    initial_response="",
                    auto_return_to_idle=False,
                    greet_on_human_detection=True,
                )
            elif result.previous_state == "WELCOME" and result.current_state != "WELCOME":
                self.welcome_interaction.stop(f"transitioned to {result.current_state}")

        level = "pass" if result.accepted else "warn"
        self.log(level, f"State request {requested_state}: {result.reason}")
        payload = result.to_dict()
        payload["stop_guard"] = stop_result
        payload["manual_neutral"] = manual_neutral
        return payload

    def welcome_wave_trigger(self, source: str = "website_wave_test", diagnostic: bool = False, arm: bool = False) -> dict[str, Any]:
        camera = status_to_dict(self.camera_service.get_status())
        wave_detector = self.update_wave_detector(camera)
        pending_confirmed = time.time() <= self.wave.pending_confirmed_until and bool(self.wave.last_confirmed_detector)
        if pending_confirmed and not wave_detector.get("confirmed", False):
            wave_detector = dict(self.wave.last_confirmed_detector)
        human_count = int(camera.get("human_count") or 0)
        detections = camera.get("detections") or []
        target = detections[0] if detections else None
        target_id = wave_detector.get("target_id") or (f"track_{target.get('track_id')}" if isinstance(target, dict) and target.get("track_id") is not None else None)
        event = {
            "type": "WELCOME_TRIGGER:WAVE",
            "source": source,
            "diagnostic": bool(diagnostic),
            "timestamp": time.time(),
            "human_count": human_count,
            "target_id": target_id,
            "track_id": wave_detector.get("track_id"),
            "confidence": float(wave_detector.get("confidence") or (1.0 if diagnostic else 0.0)),
            "score": float(wave_detector.get("score") or (1.0 if diagnostic else 0.0)),
            "side": wave_detector.get("side", "unknown"),
            "reason": "diagnostic_wave" if diagnostic else str(wave_detector.get("reason", "no_person")),
            "mode_substate": self.mode_manager.current_substate,
        }
        self.wave.last_event = event

        if arm and not wave_detector.get("confirmed", False):
            self.wave_detector.reset()
            self.camera_service.clear_wave_lock()
            self.wave.pending_confirmed_until = 0.0
            self.wave.last_confirmed_detector = {}
            self.wave.armed_until = time.time() + 12.0
            self.wave.armed_source = source
            self.wave.last_reason = "armed: waiting for real wave"
            payload = {
                "accepted": False,
                "armed": True,
                "reason": self.wave.last_reason,
                "event": event,
                "wave": self.wave_status(),
            }
            self.wave.last_result = payload
            self.log("info", "WELCOME wave test armed; waiting for confirmed wave")
            return payload

        if not self.wave.enabled:
            self.wave.rejected_count += 1
            self.wave.last_reason = "wave trigger disabled"
            payload = {"accepted": False, "reason": self.wave.last_reason, "event": event}
            self.wave.last_result = payload
            self.log("warn", "WELCOME wave trigger rejected: disabled")
            return payload

        if not diagnostic and not wave_detector.get("confirmed", False):
            self.wave.rejected_count += 1
            self.wave.last_reason = f"wave not confirmed: {event['reason']}"
            payload = {"accepted": False, "reason": self.wave.last_reason, "event": event}
            self.wave.last_result = payload
            self.log("warn", f"WELCOME wave trigger rejected: {event['reason']}")
            return payload

        context = self.safety_context(operator_request=False, welcome_trigger_confirmed=True)
        result = self.mode_manager.request_transition(
            "WELCOME",
            context,
            source=source,
            reason=f"{event['type']} accepted",
        )

        stop_result: dict[str, Any] | None = None
        if result.accepted and result.requires_stop:
            stm32 = self.hardware["stm32"]
            stop_result = self.send_stm32_stop_safe(stm32.port)
            stop_result = self.degraded_stop_guard_if_safe(stop_result)
            self.log("stop", f"WELCOME wave trigger stop guard: {stop_result['detail']}")
            if stm32.connected and not stop_result.get("ok"):
                transition = self.mode_manager.enter_error("Unable to verify stopped wheels before WELCOME wave trigger", source=source)
                self.wave.rejected_count += 1
                self.wave.last_reason = "stop guard failed"
                payload = {
                    "accepted": False,
                    "reason": "stop guard failed",
                    "event": event,
                    "stop_guard": stop_result,
                    "transition": transition.to_dict(),
                    "wave": self.wave_status(),
                }
                self.wave.last_result = payload
                self.log("error", f"WELCOME wave trigger blocked by stop guard: {stop_result['detail']}")
                return payload

        if result.accepted:
            self.wave.trigger_count += 1
            self.wave.last_reason = "wave trigger accepted"
            self.auto_welcome_no_human_since = None
            self.update_perception_workload("WELCOME")
            self.welcome_interaction.start(trigger_source=source, operator_triggered=False, auto_return_to_idle=False)
        else:
            self.wave.rejected_count += 1
            self.wave.last_reason = result.reason

        payload = result.to_dict()
        payload["event"] = event
        payload["stop_guard"] = stop_result
        payload["wave"] = self.wave_status()
        self.wave.last_result = payload
        self.log("pass" if result.accepted else "warn", f"WELCOME wave trigger: {result.reason}")
        return payload

    def update_wave_detector(self, camera_status: dict[str, Any] | None = None) -> dict[str, Any]:
        camera_status = camera_status or status_to_dict(self.camera_service.get_status())
        detector_status = self.wave_detector.update(camera_status).to_dict()
        self.wave.detector = detector_status
        self.wave.detector_status = str(detector_status.get("algorithm") or "tracked_pose_wave")
        self.wave.thresholds = dict(detector_status.get("thresholds") or self.wave_detector.thresholds())
        if detector_status.get("confirmed"):
            self.wave.pending_confirmed_until = time.time() + 1.5
            self.wave.last_confirmed_detector = dict(detector_status)
            self.camera_service.set_wave_lock(
                duration_s=4.0,
                label="WAVE LOCK",
                track_id=detector_status.get("track_id"),
                bbox=self.wave_lock_bbox(camera_status, detector_status.get("track_id")),
            )
            self.wave.last_reason = f"detected wave: {detector_status.get('reason')}"
        elif self.wave.last_event is None:
            self.wave.last_reason = str(detector_status.get("reason", "not checked"))
        return detector_status

    @staticmethod
    def wave_lock_bbox(camera_status: dict[str, Any], track_id: Any) -> list[int] | None:
        try:
            target_id = int(track_id)
        except (TypeError, ValueError):
            return None
        for detection in camera_status.get("detections") or []:
            if not isinstance(detection, dict):
                continue
            try:
                det_id = int(detection.get("track_id"))
            except (TypeError, ValueError):
                continue
            if det_id == target_id and detection.get("bbox"):
                return [int(value) for value in detection["bbox"]]
        return None

    def update_manual_enabled(self, enabled: bool) -> dict[str, Any] | None:
        self.manual.enabled = enabled
        if enabled:
            self.manual.speed_intent = 0
            self.manual.steer_intent = 0
            self.manual.blocked_reason = None
            neutral = self.send_manual_neutral("MANUAL entry")
            self.manual.last_result = neutral
            if not neutral.get("ok"):
                self.manual.enabled = False
                self.manual.blocked_reason = "manual neutral command failed"
                self.mode_manager.enter_error("MANUAL entry neutral command failed", source="manual_entry")
            return neutral
        else:
            self.manual.speed_intent = 0
            self.manual.steer_intent = 0
            self.manual.blocked_reason = "manual disabled"
            neutral = self.send_manual_neutral("MANUAL exit")
            self.manual.last_result = neutral
            return neutral
        return None

    def _send_manual_drive_command(self, speed: int, steer: int, wait_ack: bool = False, log_motion: bool = False) -> dict[str, Any]:
        if self.stm32_link is None or not self.hardware["stm32"].connected:
            return {"ok": False, "detail": "STM32 unavailable", "command": f"CMD:DRIVE:{int(speed)},{int(steer)}"}

        serial_result = self.stm32_link.send_drive(speed, steer, wait_ack=wait_ack)
        self.manual.last_command_at = time.time()
        self.manual.command_count += 1
        self.manual.last_result = serial_result
        if log_motion and (speed != 0 or steer != 0):
            self.log("drive", f"MANUAL drive speed={speed} steer={steer} result={serial_result['detail']}")
        return serial_result

    def send_manual_neutral(self, reason: str) -> dict[str, Any]:
        self.manual.speed_intent = 0
        self.manual.steer_intent = 0
        self.manual.last_neutral_at = time.time()
        if self.stm32_link is None or not self.hardware["stm32"].connected:
            result = {"ok": False, "detail": "STM32 unavailable for manual neutral", "reason": reason}
        else:
            result = self.stm32_link.send_drive(0, 0, timeout_s=0.45)
            result["reason"] = reason
        self.manual.last_neutral_result = result
        self.log("stop" if result.get("ok") else "error", f"{reason}: neutral drive result {result.get('detail')}")
        return result

    @staticmethod
    def clamp(value: int, limit: int) -> int:
        return max(-limit, min(limit, int(value)))

    def manual_drive(self, speed: int, steer: int) -> dict[str, Any]:
        if self.mode_manager.current_state != "MANUAL" or not self.manual.enabled:
            result = {"accepted": False, "reason": "manual controls are only active in MANUAL"}
            self.manual.blocked_reason = result["reason"]
            self.log("warn", f"Manual drive rejected: {result['reason']}")
            return result
        if self.stm32_link is None or not self.hardware["stm32"].connected:
            result = {"accepted": False, "reason": "STM32 unavailable"}
            self.manual.blocked_reason = result["reason"]
            self.mode_manager.enter_error("STM32 unavailable during MANUAL", source="manual")
            self.log("error", "Manual drive rejected: STM32 unavailable")
            return result

        clamped_speed = self.clamp(speed, self.manual.max_speed)
        clamped_steer = self.clamp(steer, self.manual.max_steer)
        self.manual.blocked_reason = None

        started = time.monotonic()
        wait_ack = clamped_speed == 0 and clamped_steer == 0
        serial_result = self._send_manual_drive_command(clamped_speed, clamped_steer, wait_ack=wait_ack, log_motion=True)
        elapsed_ms = (time.monotonic() - started) * 1000.0
        self.manual.speed_intent = clamped_speed
        self.manual.steer_intent = clamped_steer
        self.manual.last_intent_at = time.time()
        if clamped_speed != 0:
            self.manual.base_speed_setting = abs(clamped_speed)
        if clamped_steer != 0:
            self.manual.base_steer_setting = abs(clamped_steer)
        return {
            "accepted": bool(serial_result["ok"]),
            "speed": clamped_speed,
            "steer": clamped_steer,
            "elapsed_ms": elapsed_ms,
            "serial": serial_result,
            "blocked_reason": self.manual.blocked_reason,
        }

    def manual_arm(self, arm: int, steps: int, speed: int) -> dict[str, Any]:
        if self.mode_manager.current_state != "MANUAL" or not self.manual.enabled:
            result = {"accepted": False, "reason": "manual arm controls are only active in MANUAL"}
            self.manual.blocked_reason = result["reason"]
            self.log("warn", f"Manual arm rejected: {result['reason']}")
            return result
        if self.stm32_link is None or not self.hardware["stm32"].connected:
            result = {"accepted": False, "reason": "STM32 unavailable"}
            self.manual.blocked_reason = result["reason"]
            self.mode_manager.enter_error("STM32 unavailable during MANUAL arm", source="manual_arm")
            self.log("error", "Manual arm rejected: STM32 unavailable")
            return result

        arm_num = 2 if int(arm) == 2 else 1
        step_limit = max(1, int(self.manual.max_arm_steps))
        speed_limit = max(1, int(self.manual.max_arm_speed))
        clamped_steps = self.clamp(int(steps), step_limit)
        clamped_speed = max(2000, min(speed_limit, int(speed)))

        started = time.monotonic()
        if arm_num == 2:
            serial_result = self.stm32_link.send_arm2(clamped_steps, clamped_speed)
        else:
            serial_result = self.stm32_link.send_arm(clamped_steps, clamped_speed)
        elapsed_ms = (time.monotonic() - started) * 1000.0

        result = {
            "accepted": bool(serial_result["ok"]),
            "arm": arm_num,
            "steps": clamped_steps,
            "speed": clamped_speed,
            "elapsed_ms": elapsed_ms,
            "serial": serial_result,
        }
        self.manual.arm_step_setting = abs(clamped_steps) or self.manual.arm_step_setting
        self.manual.arm_speed_setting = clamped_speed
        self.manual.last_command_at = time.time()
        self.manual.command_count += 1
        self.manual.last_arm_command = result
        self.manual.last_result = serial_result
        self.log("drive", f"MANUAL arm{arm_num} steps={clamped_steps} speed={clamped_speed} result={serial_result['detail']}")
        return result

    def manual_stop(self) -> dict[str, Any]:
        self.manual.last_release_at = time.time()
        self.manual.speed_intent = 0
        self.manual.steer_intent = 0
        neutral = self.send_manual_neutral("MANUAL release")
        stop = self.send_stm32_stop_safe(self.hardware["stm32"].port)
        self.manual.last_result = stop
        self.log("stop", f"MANUAL stop result: neutral={neutral.get('detail')} stop={stop['detail']}")
        return {"accepted": bool(neutral.get("ok") and stop["ok"]), "speed": 0, "steer": 0, "serial": stop, "neutral": neutral}

    def start_live_dance(self, use_ultrasonic: bool = False) -> dict[str, Any]:
        if self.dance_live_thread and self.dance_live_thread.is_alive():
            return {"accepted": False, "reason": "live dance already running", "live": asdict(self.dance_live)}
        if self.stm32_link is None or not self.hardware["stm32"].connected:
            return {"accepted": False, "reason": "STM32 unavailable"}

        audio_path = self._resolve_dance_audio_path()
        if not audio_path:
            return {"accepted": False, "reason": "dance audio unavailable", "audio_file": None}

        if self.mode_manager.current_state == "DANCE":
            transition = {
                "accepted": True,
                "reason": "already in DANCE",
                "state": "DANCE",
                "substate": self.mode_manager.current_substate,
            }
        else:
            transition = self.request_state("DANCE", source="website_live_dance")
            if not transition.get("accepted"):
                return {"accepted": False, "reason": transition.get("reason", "DANCE transition rejected"), "transition": transition}

        with self.lock:
            self.dance_live = DanceLiveRuntime(
                enabled=True,
                active=True,
                use_ultrasonic=bool(use_ultrasonic),
                current_step="starting_audio",
                started_at=time.time(),
                last_update_at=time.time(),
                audio_file=audio_path,
            )
            self.dance_live_stop.clear()
        self.dance_live_thread = threading.Thread(target=self._live_dance_worker, name="pluto-live-dance", daemon=True)
        self.dance_live_thread.start()
        self.log("pass", f"Live DANCE started ({'careful' if use_ultrasonic else 'free'})")
        return {"accepted": True, "transition": transition, "live": asdict(self.dance_live)}

    def _resolve_dance_audio_path(self) -> str | None:
        configured = self.dance_planner.config.audio_file_path
        if configured and Path(configured).exists():
            return configured
        try:
            return str(self._ensure_fallback_dance_audio())
        except Exception as exc:
            self.log("warn", f"DANCE fallback audio unavailable: {exc}")
            return None

    def _ensure_fallback_dance_audio(self) -> Path:
        if DANCE_FALLBACK_AUDIO.exists() and DANCE_FALLBACK_AUDIO.stat().st_size > 1024:
            return DANCE_FALLBACK_AUDIO
        sample_rate = 22050
        duration_s = 28
        beat_hz = 2.0
        with wave.open(str(DANCE_FALLBACK_AUDIO), "wb") as wav:
            wav.setnchannels(1)
            wav.setsampwidth(2)
            wav.setframerate(sample_rate)
            frames = bytearray()
            total_samples = int(sample_rate * duration_s)
            for i in range(total_samples):
                t = i / sample_rate
                beat_phase = (t * beat_hz) % 1.0
                envelope = 1.0 if beat_phase < 0.09 else 0.22
                tone = math.sin(2.0 * math.pi * 220.0 * t) + 0.35 * math.sin(2.0 * math.pi * 440.0 * t)
                value = int(max(-1.0, min(1.0, tone * envelope * 0.38)) * 32767)
                frames.extend(int(value).to_bytes(2, byteorder="little", signed=True))
            wav.writeframes(bytes(frames))
        return DANCE_FALLBACK_AUDIO

    def stop_live_dance(self, reason: str = "operator stop") -> dict[str, Any]:
        self.dance_live_stop.set()
        if self.dance_live_thread and self.dance_live_thread.is_alive():
            self.dance_live_thread.join(timeout=1.5)
        stop = self.send_stm32_stop_safe(self.hardware["stm32"].port)
        self.audio_runtime.stop_playback(reason=reason)
        with self.lock:
            self.dance_live.active = False
            self.dance_live.enabled = False
            self.dance_live.current_step = "stopped"
            self.dance_live.last_update_at = time.time()
            self.dance_live.last_result = {"ok": bool(stop.get("ok")), "detail": reason, "stop": stop}
        self.log("stop", f"Live DANCE stopped: {reason}")
        return {"accepted": True, "reason": reason, "stop": stop, "live": asdict(self.dance_live)}

    def _live_dance_worker(self) -> None:
        try:
            audio_file = self.dance_live.audio_file
            if not audio_file:
                raise RuntimeError("dance audio file missing")
            play = self.audio_runtime.play_file_async(audio_file)
            if not play.get("ok"):
                raise RuntimeError(str(play.get("detail") or "audio playback failed"))
            self.dance_audio_started = True
            self._set_live_dance_step("forward_1", 1)
            self._live_move_distance(direction=1, speed=DANCE_MAX_SPEED, label="forward_1")
            self._set_live_dance_step("backward_1", 2)
            self._live_move_distance(direction=-1, speed=DANCE_MIN_SPEED, label="backward_1")
            self._set_live_dance_step("rotate_1", 3)
            self._live_rotate_180(label="rotate_1")
            self._set_live_dance_step("forward_2", 4)
            self._live_move_distance(direction=1, speed=DANCE_MAX_SPEED, label="forward_2")
            self._set_live_dance_step("backward_2", 5)
            self._live_move_distance(direction=-1, speed=DANCE_MIN_SPEED, label="backward_2")
            self._set_live_dance_step("rotate_2", 6)
            self._live_rotate_180(label="rotate_2")
            self.send_stm32_stop_safe(self.hardware["stm32"].port)
            with self.lock:
                self.dance_live.active = False
                self.dance_live.enabled = False
                self.dance_live.current_step = "complete"
                self.dance_live.completed_at = time.time()
                self.dance_live.last_update_at = time.time()
                self.dance_live.last_result = {"ok": True, "detail": "live dance complete"}
            self.log("pass", "Live DANCE completed")
            self.request_state("IDLE", source="dance_live_complete")
        except Exception as exc:
            self.send_stm32_stop_safe(self.hardware["stm32"].port)
            with self.lock:
                self.dance_live.active = False
                self.dance_live.enabled = False
                self.dance_live.last_error = str(exc)
                self.dance_live.current_step = "error"
                self.dance_live.last_update_at = time.time()
                self.dance_live.last_result = {"ok": False, "detail": str(exc)}
            self.log("error", f"Live DANCE stopped: {exc}")
            self.mode_manager.enter_error(f"Live DANCE failed: {exc}", source="dance_live")

    def _set_live_dance_step(self, step: str, index: int) -> None:
        with self.lock:
            self.dance_live.current_step = step
            self.dance_live.step_index = index
            self.dance_live.last_update_at = time.time()

    def _live_move_distance(self, direction: int, speed: int, label: str) -> None:
        start_distance = self._live_distance_m_or_none()
        start_heading = self._live_heading_deg_or_none()
        if start_distance is None:
            self._live_move_timed(direction, speed, label)
            return
        started = time.monotonic()
        target = DANCE_TARGET_DISTANCE_M
        while not self.dance_live_stop.is_set():
            current_distance = self._live_distance_m_or_none()
            moved = abs(current_distance - start_distance) if current_distance is not None else 0.0
            if moved >= target - DISTANCE_TOLERANCE_M:
                break
            if time.monotonic() - started > 14.0:
                raise TimeoutError(f"{label} timed out before reaching 2m")
            self._raise_if_live_obstacle()
            current_heading = self._live_heading_deg_or_none()
            heading_error = angle_delta_deg(start_heading, current_heading) if start_heading is not None and current_heading is not None else 0.0
            correction = max(-20, min(20, int(round(heading_error * 1.2))))
            command_speed = direction * abs(speed)
            command_steer = -correction
            result = self._send_live_drive(command_speed, command_steer)
            with self.lock:
                self.dance_live.measured_distance_m = moved
                self.dance_live.last_command = {"speed": command_speed, "steer": command_steer, "serial": result}
                self.dance_live.last_update_at = time.time()
            time.sleep(0.05)
        if self.dance_live_stop.is_set():
            raise RuntimeError("live dance stopped by operator")
        self.send_stm32_stop_safe(self.hardware["stm32"].port)

    def _live_move_timed(self, direction: int, speed: int, label: str) -> None:
        started = time.monotonic()
        while not self.dance_live_stop.is_set() and time.monotonic() - started < DANCE_OPEN_LOOP_MOVE_S:
            self._raise_if_live_obstacle()
            command_speed = direction * abs(speed)
            result = self._send_live_drive(command_speed, 0)
            elapsed = time.monotonic() - started
            with self.lock:
                self.dance_live.measured_distance_m = elapsed / max(0.1, DANCE_OPEN_LOOP_MOVE_S) * DANCE_TARGET_DISTANCE_M
                self.dance_live.last_command = {
                    "speed": command_speed,
                    "steer": 0,
                    "serial": result,
                    "fallback": "timed_open_loop",
                    "label": label,
                }
                self.dance_live.last_update_at = time.time()
            time.sleep(0.05)
        if self.dance_live_stop.is_set():
            raise RuntimeError("live dance stopped by operator")
        self.send_stm32_stop_safe(self.hardware["stm32"].port)

    def _live_rotate_180(self, label: str) -> None:
        start_heading = self._live_heading_deg_or_none()
        if start_heading is None:
            self._live_rotate_timed(label)
            return
        start_ticks = self._live_drive_ack_count()
        started = time.monotonic()
        while not self.dance_live_stop.is_set():
            current_heading = self._live_heading_deg_or_none()
            turned = abs(angle_delta_deg(start_heading, current_heading)) if current_heading is not None else 0.0
            if turned >= DANCE_TARGET_TURN_DEG - TURN_TOLERANCE_DEG:
                break
            if time.monotonic() - started > 10.0:
                raise TimeoutError(f"{label} timed out before reaching 180 degrees")
            result = self._send_live_drive(0, DANCE_MIN_STEER)
            with self.lock:
                self.dance_live.measured_turn_deg = turned
                self.dance_live.last_command = {"speed": 0, "steer": DANCE_MIN_STEER, "serial": result}
                self.dance_live.last_update_at = time.time()
            time.sleep(0.05)
        if self.dance_live_stop.is_set():
            raise RuntimeError("live dance stopped by operator")
        if self._live_drive_ack_count() <= start_ticks:
            raise RuntimeError(f"{label} failed validation: no drive ACK movement evidence")
        self.send_stm32_stop_safe(self.hardware["stm32"].port)

    def _live_rotate_timed(self, label: str) -> None:
        start_ticks = self._live_drive_ack_count()
        started = time.monotonic()
        while not self.dance_live_stop.is_set() and time.monotonic() - started < DANCE_OPEN_LOOP_TURN_S:
            result = self._send_live_drive(0, DANCE_MIN_STEER)
            elapsed = time.monotonic() - started
            with self.lock:
                self.dance_live.measured_turn_deg = elapsed / max(0.1, DANCE_OPEN_LOOP_TURN_S) * DANCE_TARGET_TURN_DEG
                self.dance_live.last_command = {
                    "speed": 0,
                    "steer": DANCE_MIN_STEER,
                    "serial": result,
                    "fallback": "timed_open_loop",
                    "label": label,
                }
                self.dance_live.last_update_at = time.time()
            time.sleep(0.05)
        if self.dance_live_stop.is_set():
            raise RuntimeError("live dance stopped by operator")
        if self._live_drive_ack_count() <= start_ticks:
            raise RuntimeError(f"{label} failed validation: no drive ACK movement evidence")
        self.send_stm32_stop_safe(self.hardware["stm32"].port)

    def _send_live_drive(self, speed: int, steer: int) -> dict[str, Any]:
        if self.stm32_link is None or not self.hardware["stm32"].connected:
            raise RuntimeError("STM32 unavailable during live dance")
        result = self.stm32_link.send_drive(int(speed), int(steer), wait_ack=False)
        if not result.get("ok"):
            raise RuntimeError(str(result.get("detail") or "drive command failed"))
        return result

    def _live_distance_m_or_none(self) -> float | None:
        try:
            return self._live_distance_m()
        except Exception:
            return None

    def _live_distance_m(self) -> float:
        if self.stm32_link is None:
            raise RuntimeError("STM32 unavailable during live dance")
        telemetry = self.stm32_link.get_status().telemetry
        value = telemetry.get("DIST") if telemetry else None
        if value is None:
            raise RuntimeError("encoder distance telemetry DIST missing")
        return float(value) / 100.0

    def _live_heading_deg_or_none(self) -> float | None:
        try:
            return self._live_heading_deg()
        except Exception:
            return None

    def _live_heading_deg(self) -> float:
        if self.stm32_link is None:
            raise RuntimeError("STM32 unavailable during live dance")
        status = self.stm32_link.get_status()
        orientation = status.imu_orientation or {}
        if orientation.get("available") and orientation.get("yaw") is not None:
            return float(orientation["yaw"])
        telemetry = status.telemetry or {}
        if telemetry.get("H") is not None:
            return float(telemetry["H"]) * 180.0 / 3.141592653589793
        raise RuntimeError("IMU yaw or heading telemetry missing")

    def _live_drive_ack_count(self) -> int:
        if self.stm32_link is None:
            return 0
        return int(self.stm32_link.get_status().ack_drive_count)

    def _raise_if_live_obstacle(self) -> None:
        if not self.dance_live.use_ultrasonic or self.stm32_link is None:
            return
        obstacles = self.stm32_link.get_status().obstacles or {}
        values = []
        for key in ("F", "FL", "FR"):
            try:
                values.append((key, float(obstacles[key])))
            except (KeyError, TypeError, ValueError):
                continue
        if not values:
            raise RuntimeError("careful dance requires ultrasonic obstacle telemetry")
        blocked = [(key, cm) for key, cm in values if cm < self.dance_live.obstacle_stop_cm]
        if blocked:
            key, cm = min(blocked, key=lambda item: item[1])
            raise RuntimeError(f"careful dance obstacle {key} at {cm:.0f}cm")

    def audio_status(self) -> dict[str, Any]:
        return self.audio_runtime.status()

    def refresh_audio(self) -> dict[str, Any]:
        status = self.audio_runtime.probe()
        with self.lock:
            self.hardware["microphone"] = HardwareDevice(
                "Microphone",
                False,
                connected=status.microphone_available,
                port=status.selected_microphone,
                status="connected" if status.microphone_available else "unavailable",
                detail=status.stt_detail if status.microphone_available else "no capture device selected",
                last_seen=time.time() if status.microphone_available else None,
            )
            self.hardware["speaker"] = HardwareDevice(
                "Speaker",
                False,
                connected=status.speaker_available,
                port=status.selected_speaker,
                status="connected" if status.speaker_available else "unavailable",
                detail=status.tts_detail
                if status.speaker_available
                else (
                    "playback device detected but no confirmed speaker selected"
                    if status.playback_devices
                    else "no playback device selected"
                ),
                last_seen=time.time() if status.speaker_available else None,
            )
            self.log("info", "Audio hardware refreshed")
        return status.to_dict()

    def update_perception_workload(self, current_state: str | None = None) -> None:
        state = str(current_state or self.mode_manager.current_state).upper()
        target = "REDUCED" if state == "WELCOME" else "NORMAL"
        if self.camera_service.set_perception_mode(target):
            previous = self.camera_perception_mode
            self.camera_perception_mode = target
            detail = (
                "WELCOME active: human detection reduced, wave/pose processing disabled"
                if target == "REDUCED"
                else "WELCOME inactive: normal perception restored"
            )
            self.log("info", f"Perception workload {previous} -> {target}: {detail}")

    def select_microphone(self, device: str | None) -> dict[str, Any]:
        status = self.audio_runtime.set_microphone(device)
        self.refresh_audio()
        self.log("info", f"Microphone preference set to {device or 'automatic'}")
        return status

    def select_speaker(self, device: str | None) -> dict[str, Any]:
        status = self.audio_runtime.set_speaker(device)
        self.refresh_audio()
        self.log("info", f"Speaker preference set to {device or 'automatic'}")
        return status

    def configure_welcome_interaction(self, values: dict[str, Any]) -> dict[str, Any]:
        return self.welcome_interaction.configure(values)

    def record_welcome_talk_result(self, talk_result: TalkResult) -> None:
        started = time.monotonic()
        self.log(
            "talk",
            "WELCOME TRACE web_shell.on_talk_result start / "
            f"timestamp={datetime.now().isoformat(timespec='milliseconds')} / "
            f"intent={talk_result.intent!r} / reason={talk_result.reason!r} / "
            f"latency_ms={talk_result.latency_ms!r}",
        )
        with self.lock:
            self.talk_last_result = talk_result
            self.talk_history.appendleft(talk_result)
            self.talk_last_notice = talk_result.response
        self.log(
            "talk",
            "WELCOME TRACE web_shell.on_talk_result end / "
            f"timestamp={datetime.now().isoformat(timespec='milliseconds')} / "
            f"callback_latency_ms={(time.monotonic() - started) * 1000.0:.3f} / "
            f"intent={talk_result.intent!r} / reason={talk_result.reason!r}",
        )

    def audio_speak(self, text: str) -> dict[str, Any]:
        result = self.audio_runtime.speak_async(text)
        self.log("talk" if result.get("ok") else "warn", f"Audio speak: {result.get('detail')}")
        return {"accepted": bool(result.get("ok")), "audio": result, "status": self.audio_status()}

    def welcome_talk(self, text: str, speak: bool = False) -> dict[str, Any]:
        guard = self.prepare_welcome_talk()
        if not guard["ok"]:
            return guard["payload"]
        return self.answer_welcome_talk(text, guard["stop"], speak=speak)

    def welcome_listen(self, duration_s: float = 3.0, speak: bool = False) -> dict[str, Any]:
        guard = self.prepare_welcome_talk()
        if not guard["ok"]:
            return guard["payload"]

        with self.lock:
            self.talk_last_notice = "Listening..."
            self.log("talk", f"WELCOME_TALK listening for {duration_s:.1f}s")

        listen = self.audio_runtime.listen(duration_s)
        transcript = listen.get("transcript") or {}
        text = str(transcript.get("text") or "").strip()
        payload = self.answer_welcome_talk(text, guard["stop"], speak=speak)
        payload["audio_listen"] = listen
        payload["recognized_text"] = text
        payload["audio"] = self.audio_status()
        return payload

    def prepare_welcome_talk(self) -> dict[str, Any]:
        if self.mode_manager.current_state != "WELCOME":
            self.talk_last_notice = "Enter WELCOME first."
            result = {
                "accepted": False,
                "reason": "WELCOME_TALK is only active in WELCOME",
                "state": self.mode_manager.current_state,
                "display_response": self.talk_last_notice,
            }
            self.log("warn", f"WELCOME_TALK rejected: {result['reason']}")
            return {"ok": False, "payload": result}

        stop = self.send_stm32_stop_safe(self.hardware["stm32"].port)
        stop = self.degraded_stop_guard_if_safe(stop)
        if self.hardware["stm32"].connected and not stop.get("ok"):
            self.talk_last_notice = "Stop guard failed."
            transition = self.mode_manager.enter_error("Unable to verify stopped wheels before WELCOME_TALK", source="welcome_talk")
            self.log("error", f"WELCOME_TALK blocked by stop guard: {stop['detail']}")
            result = {
                "accepted": False,
                "reason": "stop guard failed",
                "display_response": self.talk_last_notice,
                "stop_guard": stop,
                "transition": transition.to_dict(),
            }
            return {"ok": False, "payload": result}

        return {"ok": True, "stop": stop}

    def degraded_stop_guard_if_safe(self, stop: dict[str, Any]) -> dict[str, Any]:
        if stop.get("ok") or self.stm32_link is None:
            return stop
        runtime = self.stm32_link.get_status()
        now = time.time()
        recent_link = bool(runtime.running and runtime.last_seen and now - runtime.last_seen <= 2.0)
        telemetry_speed = runtime.telemetry.get("SPD") if runtime.telemetry else None
        try:
            speed_zero = abs(float(telemetry_speed or 0.0)) <= 0.01
        except (TypeError, ValueError):
            speed_zero = False
        manual_zero = self.manual.speed_intent == 0 and self.manual.steer_intent == 0
        if recent_link and speed_zero and manual_zero:
            degraded = dict(stop)
            degraded.update(
                {
                    "ok": True,
                    "acknowledged": False,
                    "degraded": True,
                    "original_detail": stop.get("detail"),
                    "detail": "STOP sent; ACK missing, link alive, speed zero",
                }
            )
            self.log("warn", f"WELCOME_TALK using degraded stop guard: {stop.get('detail')}")
            return degraded
        return stop

    def answer_welcome_talk(self, text: str, stop: dict[str, Any], speak: bool = False) -> dict[str, Any]:
        self.mode_manager.set_substate("WELCOME_TALK", return_lock=False)
        talk_result = self.talk_engine.answer(text)
        tts_result: dict[str, Any] | None = None
        if speak:
            tts_result = self.audio_runtime.speak_async(talk_result.response)
        with self.lock:
            self.talk_last_result = talk_result
            self.talk_history.appendleft(talk_result)
            self.talk_last_notice = talk_result.response
            self.log(
                "talk" if talk_result.accepted else "warn",
                f"WELCOME_TALK {talk_result.response_source} {talk_result.reason}: {talk_result.response}",
            )
        return {
            "accepted": talk_result.accepted,
            "reason": talk_result.reason,
            "state": self.mode_manager.current_state,
            "substate": self.mode_manager.current_substate,
            "stop_guard": stop,
            "talk": talk_result.to_dict(),
            "speech": tts_result,
            "display_response": talk_result.response,
        }

    def forward_obstacle_reason(self, speed: int) -> str | None:
        if speed <= 0 or self.stm32_link is None:
            return None
        status = self.stm32_link.get_status()
        obstacles = status.obstacles
        for key in ("F", "FL", "FR"):
            value = obstacles.get(key)
            if isinstance(value, (int, float)) and value < 60:
                return f"obstacle {key} at {value:.0f} cm"
        return None

    def shutdown(self, confirm: str | None) -> dict[str, Any]:
        if confirm != "PLUTO SHUTDOWN":
            self.log("warn", "Shutdown rejected because confirmation text was missing")
            return {"accepted": False, "reason": "confirmation required"}

        stop = self.emergency_stop()
        command = ["sudo", "shutdown", "-h", "now"]
        try:
            subprocess.Popen(command)
        except Exception as exc:
            self.log("error", f"Raspberry Pi shutdown command failed: {exc}")
            return {
                "accepted": False,
                "reason": str(exc),
                "command": " ".join(command),
                "stop": stop,
            }

        self.log("warn", "Raspberry Pi shutdown command executed")
        return {
            "accepted": True,
            "reason": "Raspberry Pi shutdown command executed",
            "command": " ".join(command),
            "stop": stop,
        }

    def hardware_status_for_validation(self) -> dict[str, Any]:
        with self.lock:
            return {key: asdict(value) for key, value in self.hardware.items()}

    def validation_catalog(self) -> dict[str, Any]:
        return self.validation_center.catalog(self.hardware_status_for_validation())

    def run_validation_test(self, test_id: str, confirmed: bool = False) -> dict[str, Any]:
        result = self.validation_center.run(test_id, self.hardware_status_for_validation(), context=self, confirmed=confirmed)
        level = "pass" if result.status == "PASS" else ("warn" if result.status == "WARNING" else "error")
        self.log(level, f"Validation {result.name}: {result.status}")
        payload = result.to_dict()
        payload["catalog"] = self.validation_catalog()
        return payload

    def snapshot(self) -> PlutoStatus:
        with self.lock:
            hardware = {key: value for key, value in self.hardware.items()}
            events = list(self.events)
            mode_snapshot = self.mode_manager.snapshot(self.safety_context(operator_request=True))
            stm32_runtime = stm32_status_to_dict(self.stm32_link.get_status()) if self.stm32_link else {}
            self.escalate_critical_alert_if_needed(stm32_runtime)
            self.update_perception_workload(mode_snapshot["current_state"])
            self.process_idle_wave_trigger()
            mode_snapshot = self.mode_manager.snapshot(self.safety_context(operator_request=True))
            camera_status = status_to_dict(self.camera_service.get_status())
            self.process_idle_human_trigger(camera_status)
            self.process_welcome_auto_return(camera_status)
            mode_snapshot = self.mode_manager.snapshot(self.safety_context(operator_request=True))
            welcome_approach = self.update_welcome_approach(mode_snapshot, camera_status, stm32_runtime)
            mode_snapshot = self.mode_manager.snapshot(self.safety_context(operator_request=True))
            dance = self.update_dance_runtime(mode_snapshot, camera_status, stm32_runtime)
            mode_snapshot = self.mode_manager.snapshot(self.safety_context(operator_request=True))
            status = PlutoStatus(
                current_state=mode_snapshot["current_state"],
                current_substate=mode_snapshot["current_substate"],
                fault_reason=mode_snapshot["fault_reason"],
                git_commit=self.git_commit,
                started_at=self.started_at,
                hardware=hardware,
                allowed_next_states=mode_snapshot["allowed_next_states"],
                bootstrap_report=self.bootstrap_report,
                camera=camera_status,
                mode_manager=mode_snapshot,
                stm32_runtime=stm32_runtime,
                error=self.error_status(mode_snapshot, stm32_runtime),
                manual=asdict(self.manual),
                wave=self.wave_status(),
                welcome_interaction=self.welcome_interaction.status(),
                welcome_approach=welcome_approach,
                dance=dance,
                talk=self.talk_status(),
                audio=self.audio_status(),
                events=events,
            )
            return status

    def talk_status(self) -> dict[str, Any]:
        return {
            **self.talk_engine.status(),
            "last_notice": self.talk_last_notice,
            "last_result": self.talk_last_result.to_dict() if self.talk_last_result else None,
            "history": [item.to_dict() for item in list(self.talk_history)[:8]],
        }

    def wave_status(self) -> dict[str, Any]:
        return asdict(self.wave)

    def update_welcome_approach(
        self,
        mode_snapshot: dict[str, Any] | None = None,
        camera_status: dict[str, Any] | None = None,
        stm32_runtime: dict[str, Any] | None = None,
    ) -> dict[str, Any]:
        mode_snapshot = mode_snapshot or self.mode_manager.snapshot(self.safety_context(operator_request=True))
        camera_status = camera_status or status_to_dict(self.camera_service.get_status())
        stm32_runtime = stm32_runtime or (stm32_status_to_dict(self.stm32_link.get_status()) if self.stm32_link else {})

        status = self.approach_planner.compute(
            camera_status=camera_status,
            stm32_runtime=stm32_runtime,
            wave_status=self.wave_status(),
            current_state=str(mode_snapshot.get("current_state", "UNKNOWN")),
            current_substate=str(mode_snapshot.get("current_substate", "UNKNOWN")),
        )

        if (
            status.active
            and status.target_id is not None
            and self.mode_manager.current_state == "WELCOME"
            and self.mode_manager.current_substate == "WELCOME_DETECT"
        ):
            self.mode_manager.set_substate("WELCOME_APPROACH_DRY_RUN", return_lock=False)
            status.substate = self.mode_manager.current_substate

        if status.active:
            now = time.monotonic()
            if now - self.approach_last_stop_at >= 1.0:
                stop = self.send_stm32_stop_safe(self.hardware["stm32"].port)
                status.stop_guard = self.degraded_stop_guard_if_safe(stop)
                self.approach_last_stop_at = now
                if self.hardware["stm32"].connected and not status.stop_guard.get("ok"):
                    transition = self.mode_manager.enter_error(
                        "Unable to verify stopped wheels during WELCOME_APPROACH dry-run",
                        source="welcome_approach",
                    )
                    status.active = False
                    status.proposed_motion = "stop"
                    status.proposed_speed = 0
                    status.proposed_steer = 0
                    status.reason = "stop guard failed"
                    status.stop_guard["transition"] = transition.to_dict()
                    self.log("error", f"WELCOME_APPROACH dry-run stop guard failed: {status.stop_guard.get('detail')}")
            elif not status.stop_guard:
                status.stop_guard = {"ok": True, "detail": "recent STOP guard still valid", "degraded": False}

        self.approach_status = status
        return status.to_dict()

    def update_dance_runtime(
        self,
        mode_snapshot: dict[str, Any] | None = None,
        camera_status: dict[str, Any] | None = None,
        stm32_runtime: dict[str, Any] | None = None,
    ) -> dict[str, Any]:
        mode_snapshot = mode_snapshot or self.mode_manager.snapshot(self.safety_context(operator_request=True))
        camera_status = camera_status or status_to_dict(self.camera_service.get_status())
        stm32_runtime = stm32_runtime or (stm32_status_to_dict(self.stm32_link.get_status()) if self.stm32_link else {})

        if self.mode_manager.current_state == "DANCE":
            if self.dance_started_at is None:
                self.dance_started_at = time.time()
                self.dance_audio_started = False
            if self.mode_manager.current_substate == "DANCE_READY":
                self.mode_manager.set_substate("DANCE_LIVE" if self.dance_live.active else "DANCE_DRY_RUN", return_lock=False)
        else:
            if self.dance_live.active:
                self.stop_live_dance(f"DANCE exited to {self.mode_manager.current_state}")
            if self.dance_audio_started:
                self.audio_runtime.stop_playback(reason="DANCE exited")
                self.log("info", "DANCE audio stopped")
            self.dance_audio_started = False
            self.dance_started_at = None

        status = self.dance_planner.compute(
            camera_status=camera_status,
            stm32_runtime=stm32_runtime,
            audio_status=self.audio_status(),
            current_state=self.mode_manager.current_state,
            current_substate=self.mode_manager.current_substate,
            dance_started_at=self.dance_started_at,
        )

        if status.active and self.dance_live.active:
            status.dry_run = False
            status.phase = "dance_live"
            status.audio_file = self.dance_live.audio_file
            status.audio_file_present = bool(self.dance_live.audio_file and Path(self.dance_live.audio_file).exists())
            status.audio_status = "playing" if self.dance_audio_started else "starting"
            status.dance_step = self.dance_live.current_step
            status.proposed_motion = "live_sequence"
            status.proposed_speed = int((self.dance_live.last_command or {}).get("speed") or 0)
            status.proposed_steer = int((self.dance_live.last_command or {}).get("steer") or 0)
            status.reason = self.dance_live.last_error or (
                "live dance running with ultrasonic careful mode"
                if self.dance_live.use_ultrasonic
                else "live dance running in free mode"
            )
            status.stop_guard = {"ok": True, "detail": "live dance owns motor commands", "degraded": False}
        elif status.active:
            if not self.dance_audio_started and status.audio_status == "ready" and status.audio_file:
                play = self.audio_runtime.play_file_async(status.audio_file)
                self.dance_audio_started = bool(play.get("ok"))
                if play.get("ok"):
                    self.log("pass", f"DANCE audio started: {status.audio_file}")
                else:
                    self.log("warn", f"DANCE audio failed: {play.get('detail')}")
            now = time.monotonic()
            if now - self.dance_last_stop_at >= 1.0:
                stop = self.send_stm32_stop_safe(self.hardware["stm32"].port)
                status.stop_guard = self.degraded_stop_guard_if_safe(stop)
                self.dance_last_stop_at = now
                if self.hardware["stm32"].connected and not status.stop_guard.get("ok"):
                    transition = self.mode_manager.enter_error(
                        "Unable to verify stopped wheels during DANCE dry-run",
                        source="dance",
                    )
                    status.active = False
                    status.proposed_motion = "stop"
                    status.proposed_speed = 0
                    status.proposed_steer = 0
                    status.reason = "stop guard failed"
                    status.stop_guard["transition"] = transition.to_dict()
                    self.log("error", f"DANCE dry-run stop guard failed: {status.stop_guard.get('detail')}")
            elif not status.stop_guard:
                status.stop_guard = {"ok": True, "detail": "recent STOP guard still valid", "degraded": False}

        self.dance_status = status
        payload = status.to_dict()
        payload["live"] = asdict(self.dance_live)
        return payload

    def process_idle_wave_trigger(self) -> None:
        if self.mode_manager.current_state != "IDLE" or not self.wave.enabled:
            return
        detector = dict(self.wave.detector or self.update_wave_detector())
        if not detector.get("confirmed", False):
            return
        source = self.wave.armed_source if time.time() <= self.wave.armed_until and self.wave.armed_source else "camera_wave"
        result = self.welcome_wave_trigger(source=source, diagnostic=False)
        if result.get("accepted"):
            self.wave.armed_until = 0.0
            self.wave.armed_source = None
            self.log("pass", "IDLE real wave detected; WELCOME requested")

    def process_idle_human_trigger(self, camera_status: dict[str, Any] | None = None) -> None:
        if self.mode_manager.current_state != "IDLE":
            return
        camera_status = camera_status or status_to_dict(self.camera_service.get_status())
        if int(camera_status.get("human_count") or 0) <= 0:
            return
        detections = [item for item in (camera_status.get("detections") or []) if isinstance(item, dict)]
        best = max(detections, key=lambda item: float(item.get("confidence") or 0.0), default={})
        confidence = float(best.get("confidence") or 0.0)
        if detections and confidence < 0.30:
            return

        result = self.mode_manager.request_transition(
            "WELCOME",
            self.safety_context(operator_request=False, welcome_trigger_confirmed=True),
            source="camera_human",
            reason="IDLE human detected",
        )
        stop_result: dict[str, Any] | None = None
        if result.accepted and result.requires_stop:
            stop_result = self.degraded_stop_guard_if_safe(self.send_stm32_stop_safe(self.hardware["stm32"].port))
            self.log("stop", f"IDLE human WELCOME stop guard: {stop_result.get('detail')}")
            if self.hardware["stm32"].connected and not stop_result.get("ok"):
                transition = self.mode_manager.enter_error("Unable to verify stopped wheels before human WELCOME", source="camera_human")
                self.log("error", f"IDLE human WELCOME blocked by stop guard: {stop_result.get('detail')}")
                self.welcome_interaction.stop("human WELCOME stop guard failed")
                self.auto_welcome_no_human_since = None
                return

        if result.accepted:
            self.auto_welcome_no_human_since = None
            self.update_perception_workload("WELCOME")
            self.welcome_interaction.start(
                trigger_source="camera_human",
                operator_triggered=False,
                initial_response="",
                auto_return_to_idle=True,
                greet_on_human_detection=False,
            )
            self.log("pass", f"IDLE human detected; WELCOME auto-started at confidence {confidence:.2f}")
        else:
            self.log("warn", f"IDLE human WELCOME rejected: {result.reason}")

    def process_welcome_auto_return(self, camera_status: dict[str, Any] | None = None) -> None:
        if self.mode_manager.current_state != "WELCOME":
            self.auto_welcome_no_human_since = None
            return
        interaction = self.welcome_interaction.status()
        if not interaction.get("auto_return_to_idle"):
            self.auto_welcome_no_human_since = None
            return
        active_states = {"HUMAN_DETECTED", "ACTIVE_LISTENING", "WAITING_FOR_RESPONSE", "SPEAKING", "POST_TTS_BUFFER"}
        if interaction.get("current_welcome_state") in active_states:
            self.auto_welcome_no_human_since = None
            return
        camera_status = camera_status or status_to_dict(self.camera_service.get_status())
        human_present = int(camera_status.get("human_count") or 0) > 0
        if human_present:
            self.auto_welcome_no_human_since = None
            return
        now = time.monotonic()
        if self.auto_welcome_no_human_since is None:
            self.auto_welcome_no_human_since = now
            return
        if now - self.auto_welcome_no_human_since < 1.0:
            return

        stop = self.degraded_stop_guard_if_safe(self.send_stm32_stop_safe(self.hardware["stm32"].port))
        result = self.mode_manager.request_transition(
            "IDLE",
            self.safety_context(operator_request=False),
            source="welcome_auto_return",
            reason="auto WELCOME human no longer detected",
        )
        if result.accepted:
            self.welcome_interaction.stop("auto WELCOME returned to IDLE after human left")
            self.auto_welcome_no_human_since = None
            self.log("pass", f"Auto WELCOME returned to IDLE; stop guard: {stop.get('detail')}")
        else:
            self.log("warn", f"Auto WELCOME return to IDLE rejected: {result.reason}")

    def error_status(self, mode_snapshot: dict[str, Any], stm32_runtime: dict[str, Any]) -> dict[str, Any]:
        in_error = mode_snapshot["current_state"] == "ERROR"
        stm32_available = self.hardware["stm32"].connected
        return {
            "active": in_error,
            "fault_reason": mode_snapshot.get("fault_reason"),
            "previous_state": self.previous_state_before_error(mode_snapshot),
            "recovery_action": self.recovery_action(in_error, stm32_available),
            "stm32_available": stm32_available,
            "last_alert": (stm32_runtime.get("alerts") or [None])[0],
        }

    def previous_state_before_error(self, mode_snapshot: dict[str, Any]) -> str | None:
        for item in reversed(mode_snapshot.get("transition_log", [])):
            if item.get("next_state") == "ERROR" and item.get("accepted"):
                return item.get("previous_state")
        return None

    @staticmethod
    def recovery_action(in_error: bool, stm32_available: bool) -> str:
        if not in_error:
            return "No active fault"
        if stm32_available:
            return "Inspect fault, confirm motors are safe, then press Reset To IDLE"
        return "Reconnect STM32, refresh hardware, then reset"

    def escalate_critical_alert_if_needed(self, stm32_runtime: dict[str, Any]) -> None:
        alerts = stm32_runtime.get("alerts") or []
        if not alerts or self.mode_manager.current_state == "ERROR":
            return
        alert = str(alerts[0])
        critical_tokens = ("CRITICAL", "FAULT", "TIMEOUT", "ESTOP", "LOW_BAT", "DISCONNECT")
        if alert == self.last_alert_escalated:
            return
        if any(token in alert.upper() for token in critical_tokens):
            self.last_alert_escalated = alert
            stop = self.send_stm32_stop_safe(self.hardware["stm32"].port)
            result = self.mode_manager.enter_error(f"STM32 critical alert: {alert}", source="stm32_alert")
            self.manual.enabled = False
            self.manual.speed_intent = 0
            self.manual.steer_intent = 0
            self.log("error", f"Critical alert escalated to ERROR: {alert}; stop result: {stop['detail']}; {result.reason}")


def read_git_commit() -> str:
    try:
        result = subprocess.run(
            ["git", "rev-parse", "--short", "HEAD"],
            check=False,
            stdout=subprocess.PIPE,
            stderr=subprocess.DEVNULL,
            text=True,
            timeout=1,
        )
        return result.stdout.strip() or "unknown"
    except Exception:
        return "unknown"


def unique(items: Iterable[str]) -> list[str]:
    seen: set[str] = set()
    out: list[str] = []
    for item in items:
        if item and item not in seen:
            seen.add(item)
            out.append(item)
    return out


def candidate_ports() -> list[str]:
    ports: list[str] = []
    try:
        import serial.tools.list_ports  # type: ignore

        ports.extend(port.device for port in serial.tools.list_ports.comports())
    except Exception:
        pass

    system = platform.system().lower()
    if system == "linux":
        ports.extend(glob.glob("/dev/ttyACM*"))
        ports.extend(glob.glob("/dev/ttyUSB*"))
        ports.extend(glob.glob("/dev/serial/by-id/*"))
    elif system == "darwin":
        ports.extend(glob.glob("/dev/tty.usbmodem*"))
        ports.extend(glob.glob("/dev/tty.usbserial*"))
    elif system == "windows" and not ports:
        ports.extend(f"COM{i}" for i in range(1, 33))

    return unique(ports)


def serial_open(port: str, baud: int):
    import serial  # type: ignore

    return serial.Serial(port=port, baudrate=baud, timeout=0.02, write_timeout=0.1)


def serial_write(ser, command: str) -> None:
    ser.write((command.strip() + "\n").encode("ascii"))
    ser.flush()


def serial_read_line(ser) -> str | None:
    raw = ser.readline()
    if not raw:
        return None
    return raw.decode("utf-8", errors="replace").strip()


def probe_stm32(ports: list[str], baud: int) -> HardwareDevice:
    if not ports:
        return HardwareDevice("STM32 motor safety controller", True, status="missing", detail="no serial ports found")

    for port in ports:
        try:
            with serial_open(port, baud) as ser:
                time.sleep(0.15)
                started = time.monotonic()
                serial_write(ser, "CMD:PING")
                deadline = started + 0.25
                seen: list[str] = []
                while time.monotonic() < deadline:
                    line = serial_read_line(ser)
                    if not line:
                        continue
                    seen.append(line)
                    if (
                        line == "ACK:PING"
                        or line == STM32_ID
                        or line.startswith("TEL:")
                        or line.startswith("OBS:")
                        or line.startswith("IMU:")
                    ):
                        serial_write(ser, "CMD:STOP")
                        return HardwareDevice(
                            "STM32 motor safety controller",
                            True,
                            connected=True,
                            port=port,
                            status="connected",
                            detail=line,
                            latency_ms=(time.monotonic() - started) * 1000.0,
                            last_seen=time.time(),
                        )
        except Exception:
            continue

    return HardwareDevice("STM32 motor safety controller", True, status="missing", detail="STM32 identity not found")


def probe_uno(ports: list[str], baud: int, skip_port: str | None = None) -> HardwareDevice:
    for port in ports:
        if skip_port and port == skip_port:
            continue
        try:
            with serial_open(port, baud) as ser:
                time.sleep(1.2)
                serial_write(ser, "ID?")
                deadline = time.monotonic() + 0.8
                while time.monotonic() < deadline:
                    line = serial_read_line(ser)
                    if line == UNO_ID:
                        return HardwareDevice(
                            "Uno LCD face controller",
                            False,
                            connected=True,
                            port=port,
                            status="connected",
                            detail=line,
                            last_seen=time.time(),
                        )
        except Exception:
            continue

    return HardwareDevice("Uno LCD face controller", False, status="unavailable", detail="optional hardware not detected")


def send_stm32_stop(port: str | None, baud: int) -> dict[str, Any]:
    if not port:
        return {"ok": False, "detail": "STM32 port unknown"}

    try:
        with serial_open(port, baud) as ser:
            started = time.monotonic()
            serial_write(ser, "CMD:STOP")
            deadline = started + 0.15
            lines: list[str] = []
            while time.monotonic() < deadline:
                line = serial_read_line(ser)
                if not line:
                    continue
                lines.append(line)
                if line == "ACK:STOP":
                    return {
                        "ok": True,
                        "detail": "ACK:STOP",
                        "latency_ms": (time.monotonic() - started) * 1000.0,
                        "lines": lines,
                    }
            return {"ok": False, "detail": "STOP sent but ACK:STOP not received within 150 ms", "lines": lines}
    except Exception as exc:
        return {"ok": False, "detail": str(exc)}


def encode_json(data: Any) -> bytes:
    def default(value: Any) -> Any:
        if hasattr(value, "__dataclass_fields__"):
            return asdict(value)
        return str(value)

    return json.dumps(data, default=default, indent=2).encode("utf-8")
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
