abdellrahmanv/PLUTO-2026/tools/uno_probe.py

#!/usr/bin/env python3
"""
Pluto Phase 2 Uno/LCD serial validation probe.

This tool proves the Raspberry Pi can identify and command the LCD/face
controller. It is safe by design: it never talks to STM32 and never sends motor
commands.
"""

from __future__ import annotations

import argparse
import glob
import json
import platform
import sys
import time
from dataclasses import dataclass, field
from typing import Iterable


UNO_ID = "ID:UNO_LCD"
IDENTITY_COMMANDS = ("ID?", "PING")
COMMAND_SEQUENCE = (
    ("MODE:BOOT", ("ACK:MODE", "ACK:MODE:BOOT")),
    ("FACE:IDLE", ("ACK:FACE", "ACK:FACE:IDLE")),
    ("FACE:HAPPY", ("ACK:FACE", "ACK:FACE:HAPPY")),
    ("FACE:THINKING", ("ACK:FACE", "ACK:FACE:THINKING")),
    ("TEXT:PLUTO PHASE 2", ("ACK:TEXT", "ACK:TEXT:PLUTO PHASE 2")),
    ("MODE:IDLE", ("ACK:MODE", "ACK:MODE:IDLE")),
)


@dataclass
class CommandResult:
    command: str
    ok: bool
    ack_line: str | None = None
    latency_ms: float | None = None
    lines: list[str] = field(default_factory=list)
    error: str | None = None


@dataclass
class UnoProbeResult:
    port: str | None = None
    detected: bool = False
    identity_line: str | None = None
    command_results: list[CommandResult] = field(default_factory=list)
    scanned_ports: list[str] = field(default_factory=list)
    failures: list[str] = field(default_factory=list)
    warnings: list[str] = field(default_factory=list)

    @property
    def pass_phase_2(self) -> bool:
        return (
            self.detected
            and self.identity_line == UNO_ID
            and bool(self.command_results)
            and all(item.ok for item in self.command_results)
            and not self.failures
        )
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
