abdellrahmanv/PLUTO-2026/(commit log)

2026-05-24 Add Pluto STM32 and Raspberry Pi deploy
2026-05-24 Add Raspberry Pi auto-start scripts
2026-05-24 Force Pluto hotspot on Raspberry Pi boot
2026-05-24 Use single Raspberry Pi boot service for Pluto
2026-05-25 fix: website crash on Raspberry Pi - null telemetry, touch reliability, keyboard controls
    - Fix TypeError crash when telemetry/obstacles data is null (STM32 not connected)
    - Add pointercancel handler for reliable mobile touch stop
    - Add keyboard arrow key controls for desktop testing
    - Add touch-action:none to prevent ghost scrolling on mobile pad
    - Add inline favicon to suppress 404 log spam
    - Sync slider max with server MAX_SPEED/MAX_STEER config
    - Increase poll interval to 400ms to reduce load on Pi
2026-05-25 fix: WiFi hotspot not starting after reboot - race condition with NetworkManager
    - Wait up to 30s for NetworkManager to be fully operational before hotspot setup
    - Wait up to 20s for wlan0 WiFi device to appear
    - Retry hotspot creation up to 3 times if it fails
    - Add NetworkManager-wait-online.service to systemd dependencies
    - Add 2s delay after forcing WiFi radio on
2026-05-25 Fix STM32 serial selection and manual drive repeat
2026-05-25 Remove Raspberry Pi deployment prototype
2026-05-25 Harden requirements with timing power and welcome details
2026-05-25 Add Raspberry Pi bootstrap and hardware detection requirements
2026-05-25 Add crowd return audio arm and memory format requirements
2026-05-26 Initiate phase 1 STM32 serial validation
2026-05-26 Initiate phase 4 camera feed and human detection
2026-05-26 Stabilize phase 4 human detection
    [camera.py, web_shell.py]
2026-05-26 Initiate phase 8 error state
    [error_state_smoke.py, mode_manager.py, web_shell.py]
2026-05-26 Tighten error reset path
    [error_state_smoke.py, web_shell.py]
2026-05-27 Retry STM32 stop guard for welcome talk
2026-05-27 Skip silent audio before STT
    [audio_io.py]
2026-05-27 Tune camera mic silence gate
2026-05-29 Use optical flow for lightweight wave detection
2026-05-29 Make wave test arm real detection
2026-05-29 Prevent wave false positives from broad motion
    [camera.py, wave_detection.py, web_shell.py, welcome_wave_smoke.py]
2026-05-29 Avoid slow non-capture camera probes
    [camera.py]
2026-05-29 Sample wave detector continuously
2026-05-30 Phase 1: STM32 link extensions and robust mock serial testing
    Model: Antigravity (DeepMind AI)
    Notes: Addresses main engineer's feedback by adding return_active tracking, explicit physical boundaries and mechanical strain warnings to send_arm(), completely refactoring stm32_link_extensions_smoke.py with a FakeSerial mock to assert exact command strings, adding requirements IF-STM32-013/014/015 to SYSTEM_REQUIREMENTS.md, and creating a template-compliant feature memory file.
2026-05-30 docs: Add ANTIGRAVITY_SESSION_LOG.md to feature memory
    Notes: Creates a comprehensive engineering session log detailing every single code change, rationale, requirement trace, exact diffs, test logs, and safety mitigation notes for other editors and the main engineer.
    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
2026-06-02 Add dance envelope odometry evidence
2026-06-02 Add variable manual motor controls
2026-06-02 Update STM32 second arm pin map
2026-06-02 Fix STM32 arm command ACK order
    [main.c]
2026-06-02 Stabilize STM32 zero-step arm ACKs
    [main.c]
2026-06-12 Checkpoint Pluto sensor dashboard and STM32 controls
    [back_leftwheel.STL, back_rigtwheel.STL, base_link.STL, front_leftwheel.STL, front_rightwheel.STL, leftarm.STL, rightarm.STL]
2026-06-13 Configure stepper motor for common cathode and enable pin control
2026-06-13 Set TB6600 common-anode stepper signaling
2026-06-13 Use proven manual arm test range in web controls
2026-06-14 Document fast Raspberry Pi website run path
2026-06-14 Fix arm speed limits and resonance protection in web control
    [web_shell.py]
2026-06-18 Add validation center and harden arm controls
2026-06-18 Add Raspberry Pi Wi-Fi portal deployment
2026-06-18 Wait for Wi-Fi device before configuring Pi AP
2026-06-19 Fix speaker detection and manual range gating
    [audio_io.py, audio_io_smoke.py, manual_state_smoke.py, web_shell.py]
2026-06-19 Fix manual drive UART mapping and cadence
    [manual_state_smoke.py, web_shell.py]
2026-06-19 Reconnect STM32 serial runtime after read errors
    [stm32_link.py]
2026-06-19 Fix manual forward backward pad mapping
    [manual_state_smoke.py, web_shell.py]
2026-06-19 Fix manual backward safety and pad hold handling
    [main.c, web_shell.py]
2026-06-19 Fix manual mode neutral authority
    [main.c, manual_state_smoke.py, stm32_link.py, stm32_link_extensions_smoke.py, web_shell.py]
2026-06-19 Add Stage 2 validation tests
2026-06-20 Wire Uno command buttons to Raspberry Pi
2026-06-20 Wire live dance to website
2026-06-20 Revert "Improve WELCOME audio latency visibility"
    This reverts commit 6caf15fc13dac79903bed59edc6f9fdda8cdbffe.
    [audio_io.py, web_shell.py, welcome_interaction.py]
2026-06-20 Tighten WELCOME FSM transition latency
    [web_shell.py, welcome_interaction.py]
2026-06-20 Add WELCOME interaction trace logs
2026-06-20 Fix WELCOME fuzzy matching and auto listen grace
    [web_shell.py, welcome_interaction.py, welcome_interaction_smoke.py, welcome_talk.py, welcome_talk_smoke.py]
2026-06-20 Fix STM32 numeric telemetry formatting
    [main.c, validation_stage2.py]
2026-06-20 Fix mission log manual scrolling
    [web_shell.py]
2026-06-22 Stabilize Pi Wi-Fi portal startup
    [pi_deployment_smoke.py, web_shell.py]
